ahkar-kyaw/e_me599_Hermes/01_document/Hermes_LaTeX_Thesis/chapters/chapter02.tex

\chapter{Background and Literature Review} \label{sec:Background and Literature Review}
    [aaa]

\section{Inverted-Pendulum Robots} \label{sec:Inverted-Pendulum Robots}
    [aaa]

\section{Mecanum Wheels} \label{sec:Mecanum Wheels}
    [aaa]

\section{CMD Theory} \label{sec:CMD Theory}
    [aaa]

\section{Relevent Control Methods} \label{sec:Relevent Control Methods}
    [aaa]

\section{Practical Nonidealities} \label{sec:Practical Nonidealities}
    [aaa]
