ahkar-kyaw/e_me599_Hermes/01_document/Hermes_LaTeX_Thesis/chapters/chapter04.tex

\chapter{Mechanical Design} \label{sec:Mechanical Design}
    [aaa]

\section{Geometry} \label{sec:Geometry}
    [aaa]

\section{Structure} \label{sec:Structure}
    [aaa]

\section{Mass Properties} \label{sec:Mass Properties}
    [aaa]

\section{Wheels} \label{sec:Wheels}
    [aaa]

\section{Actuators} \label{sec:Actuators}
    [aaa]

\section{Manufacturability} \label{sec:Manufacturability}
    [aaa]

\section{Assembly} \label{sec:Assembly}
    [aaa]

\section{Parameter Measurements} \label{sec:Parameter Measurements}
    [aaa]
