ahkar-kyaw/e_me599_Hermes/01_document/Hermes_LaTeX_Thesis/chapters/chapter05.tex

\chapter{Electrical and Embedded Design} \label{sec:Electrical and Embedded Design}
    [aaa]

\section{Power System} \label{sec:Power System}
    [aaa]

\section{Communication} \label{sec:Communication}
    [aaa]

\section{Sensing} \label{sec:Sensing}
    [aaa]

\section{Custom Electronics} \label{sec:Custom Electronics}
    [aaa]

\section{Timing} \label{sec:Timing}
    [aaa]

\section{Firmware Architecture} \label{sec:Firmware Architecture}
    [aaa]

\section{Safety States} \label{sec:Safety States}
    [aaa]
