ahkar-kyaw/e_me599_Hermes/01_document/Hermes_LaTeX_Thesis/chapters/chapter06.tex

\chapter{Modeling and System Identification} \label{sec:Modeling and System Identification}
    [aaa]

\section{Coordinates} \label{sec:Coordinates}
    [aaa]

\section{Assumptions} \label{sec:Assumptions}
    [aaa]

\section{Kinematics} \label{sec:Kinematics}
    [aaa]

\section{Reduced Dynamics} \label{sec:Reduced Dynamics}
    [aaa]

\section{Linearization} \label{sec:Linearization}
    [aaa]

\section{Actuator Model} \label{sec:Actuator Model}
    [aaa]

\section{Measured Parameters} \label{sec:Measured Parameters}
    [aaa]

\section{Validation Plan} \label{sec:Validation Plan}
    [aaa]
