ahkar-kyaw/e_me599_Hermes/01_document/Hermes_LaTeX_Thesis/chapters/chapter07.tex

\chapter{State Estimation and Control} \label{sec:State Estimation and Control}
    [aaa]

\section{Estimator} \label{sec:Estimator}
    [aaa]

\section{Balance Controller} \label{sec:Balance Controller}
    [aaa]

\section{Outer Loops} \label{sec:Outer Loops}
    [aaa]

\section{Command Allocation} \label{sec:Command Allocation}
    [aaa]

\section{Filters} \label{sec:Filters}
    [aaa]

\section{Saturation} \label{sec:Saturation}
    [aaa]

\section{Stability} \label{sec:Stability}
    [aaa]
    
\section{Controllability Discussion} \label{sec:Controllability Discussion}
    [aaa]
