ahkar-kyaw/e_me599_Hermes/01_document/Hermes_LaTeX_Thesis/chapters/chapter08.tex

\chapter{Simulation} \label{sec:Simulation}
    [aaa]

\section{/* Test case matched to planned hardware experiments */} \label{sec:/* Test case matched to planned hardware experiments */}
    [aaa]

\section{Sensitivity Studies} \label{sec:Sensitivity Studies}
    [aaa]

\section{Expected Limits} \label{sec:Expected Limits}
    [aaa]
