ahkar-kyaw/e_me599_Hermes/01_document/Hermes_LaTeX_Thesis/chapters/chapter09.tex

\chapter{Experimental Methods} \label{sec:Experimental Methods}
    [aaa]

\section{Apparatus} \label{sec:Apparatus}
    [aaa]

\section{Calibration} \label{sec:Calibration}
    [aaa]

\section{Test Matrix} \label{sec:Test Matrix}
    [aaa]

\section{Repetitions} \label{sec:Repetitions}
    [aaa]

\section{Metrics} \label{sec:Metrics}
    [aaa]

\section{Uncertainty} \label{sec:Uncertainty}
    [aaa]

\section{Data Processing} \label{sec:Data Processing}
    [aaa]
