ahkar-kyaw/e_me599_Hermes/01_document/Hermes_LaTeX_Thesis/frontmatter/abstract.tex

[aaa]. This thesis documents the design and development of Hermes, a self-balancing mobile robot with a collinear four-wheel mecanum drive. The project integrates [aaa]. [aaa]
