ahkar-kyaw/e_me599_Hermes/01_document/Hermes_LaTeX_Thesis/frontmatter/information.tex

\title{Design and Development of a Self-Balancing Mobile Robot with a Collinear Four-Wheel Mecanum Drive}
\author{Ahkar Kyaw}
\degreemonth{December}
\degreeyear{2026}
\degree{Master of Science}
\field{Mechanical Engineering}
\numberofmembers{3}
   \chair{Hasan Mohammad, Ph.D. \linebreak Assistant Professor of Mechanical Engineering}
   \othermemberA{Charlie T. Refvem, Ph.D. \linebreak Lecturer of Mechanical Engineering}
   \othermemberB{Carlos Diaz Alvarenga, Ph.D. \linebreak Professor of Computer Engineering}
   \othermemberC{Faculty Member, Ph.D. \linebreak Professor of Some Department}
   \othermemberD{Faculty Member, Ph.D. \linebreak Professor of Some Department}
   \othermemberE{Faculty Member, Ph.D. \linebreak Professor of Some Department}
   \othermemberF{Faculty Member, Ph.D. \linebreak Professor of Some Department}
   \othermemberG{Faculty Member, Ph.D. \linebreak Professor of Some Department}
   \othermemberH{Faculty Member, Ph.D. \linebreak Professor of Some Department}
   \othermemberI{Faculty Member, Ph.D. \linebreak Professor of Some Department}
\keywords{Mecanum wheel, self-balancing robot, omnidirectional mobility, wheeled inverted pendulum, embedded control, CAN bus, mechatronics}
