ahkar-kyaw/e_me599_Hermes/01_document/Hermes_LaTeX_Thesis/config/metadata.tex

\newcommand{\ThesisTitle}{Design and Development of Hermes: A Self-Balancing Mobile Robot with a Collinear Four-Wheel Mecanum Drive}
\newcommand{\ThesisAuthor}{Ahkar Kyaw}
\newcommand{\UniversityName}{California Polytechnic State University, San Luis Obispo}
\newcommand{\DegreeName}{Master of Science in Mechanical Engineering}
\newcommand{\SubmissionDate}{December 2026}
\newcommand{\CopyrightYear}{2026}

\newcommand{\CommitteeChairName}{Hasan Mohammad, Ph.D.}
\newcommand{\CommitteeChairTitle}{COMMITTEE CHAIR TITLE}
\newcommand{\CommitteeMemberOneName}{Charlie T. Refvem}
\newcommand{\CommitteeMemberOneTitle}{COMMITTEE MEMBER TITLE}
\newcommand{\CommitteeMemberTwoName}{Carlos Diaz Alvarenga, Ph.D.}
\newcommand{\CommitteeMemberTwoTitle}{COMMITTEE MEMBER TITLE}

% Change this to \usebibliographytrue after adding cited entries to references.bib.
\newif\ifusebibliography
\usebibliographyfalse
