ahkar-kyaw/e_me599_Hermes/01_document/Hermes_LaTeX_Thesis/main.pdf

DESIGN AND DEVELOPMENT OF A SELF-BALANCING MOBILE ROBOT

WITH A COLLINEAR FOUR-WHEEL MECANUM DRIVE

A Thesis

presented to

the Faculty of California Polytechnic State University,

San Luis Obispo

In Partial Fulfillment

of the Requirements for the Degree

Master of Science in Mechanical Engineering

by

Ahkar Kyaw

December 2026

© 2026

Ahkar Kyaw

ALL RIGHTS RESERVED

ii

COMMITTEE MEMBERSHIP

TITLE: Design and Development of a Self-Balancing Mobile

Robot with a Collinear Four-Wheel Mecanum Drive

AUTHOR: Ahkar Kyaw

DATE SUBMITTED: December 2026

COMMITTEE CHAIR: Hasan Mohammad, Ph.D. Assistant Professor of Mechanical Engineering

COMMITTEE MEMBER: Charlie T. Refvem, Ph.D. Lecturer of Mechanical Engineering

COMMITTEE MEMBER: Carlos Diaz Alvarenga, Ph.D. Professor of Computer Engineering

iii

ABSTRACT

Design and Development of a Self-Balancing Mobile Robot with a Collinear

Four-Wheel Mecanum Drive

Ahkar Kyaw

[aaa]. This thesis documents the design and development of Hermes, a self-balancing

mobile robot with a collinear four-wheel mecanum drive. The project integrates [aaa].

[aaa]

Keywords: Mecanum wheel, self-balancing robot, omnidirectional mobility, wheeled

inverted pendulum, embedded control, CAN bus, mechatronics

iv

TABLE OF CONTENTS

Page

CHAPTER

v

vi

vii

APPENDICES

viii

ix

LIST OF TABLES

Table | Page

x

LIST OF FIGURES

Figure | Page
B.2 | This is the caption for another image where the description is rather
C.2 | This is the caption for another image where the description is rather

xi

LIST OF SYMBOLS

Number Sets

C | Complex numbers
H | Quaternions
R | Real numbers

Other Symbols

µ | Friction index
T | Lorem ipsum dolor sit amet, consectetuer adipiscing elit. Ut purus elit, ve- stibulum ut, placerat ac, adipiscing vitae, felis. Curabitur dictum gravida mauris. Nam arcu libero, nonummy eget, consectetuer id, vulputate a, ma- gna. Donec vehicula augue eu neque. Pellentesque habitant morbi tristique senectus et netus et malesuada fames ac turpis egestas. Mauris ut leo. Cras viverra metus rhoncus sem. Nulla et lectus vestibulum urna fringilla ultrices. Phasellus eu tellus sit amet tortor gravida placerat. Integer sapien est, iaculis in, pretium quis, viverra ac, nunc. Praesent eget sem vel leo ultrices biben- dum. Aenean faucibus. Morbi dolor nulla, malesuada eu, pulvinar at, mollis ac, nulla. Curabitur auctor semper nulla. Donec varius orci eget risus. Duis nibh mi, congue eu, accumsan eleifend, sagittis quis, diam. Duis eget orci sit amet orci dignissim rutrum. Nam dui ligula, fringilla a, euismod sodales, sollicitudin vel, wisi. Morbi auctor lorem non justo. Nam lacus libero, pretium at, lobortis vitae, ultricies et, tellus. Donec aliquet, tortor sed accumsan bibendum, erat ligula aliquet magna, vitae ornare odio metus a mi. Morbi ac orci et nisl hendrerit mollis. Suspendisse ut massa. Cras nec ante. Pellentesque a nulla. Cum sociis natoque penatibus et magnis dis parturient montes, nascetur ridiculus mus. Aliquam tincidunt urna. Nulla ullamcorper vestibulum turpis. Pellentesque cursus luctus mauris. Nulla malesuada porttitor diam. Donec felis erat, congue non, volutpat at, tincidunt tristique, libero. Vivamus viverra fermentum felis. Donec nonummy pellentesque ante. Phasellus adipiscing semper elit. Proin fermentum massa ac quam. Sed diam turpis, molestie vitae, placerat a, molestie nec, leo. Maecenas lacinia. Nam ipsum ligula, eleifend at, accumsan nec, suscipit a, ipsum. Morbi blandit ligula feugiat magna. Nunc eleifend consequat lorem. Sed lacinia nulla vitae enim. Pellentesque tincidunt purus vel magna. Integer non enim. Prae- sent euismod nunc eu purus. Donec bibendum quam in tellus. Nullam cursus pulvinar lectus. Donec et mi. Nam vulputate metus eu enim. Vestibulum pellentesque felis eu massa.
| xii

V Constant volume

Physics Constants

c | Speed of light in a vacuum
G | Gravitational constant
h | Planck constant

xiii

Chapter 1

INTRODUCTION

[aaa]

### 1.1 Motivation

[aaa]

### 1.2 Problem Statement

[aaa]

### 1.3 Research Gap

[aaa]

### 1.4 Questions

[aaa]

### 1.5 Contributions

[aaa]

### 1.6 Scope

[aaa]

Chapter 2

BACKGROUND AND LITERATURE REVIEW

[aaa]

### 2.1 Inverted-Pendulum Robots

[aaa]

### 2.2 Mecanum Wheels

[aaa]

### 2.3 CMD Theory

[aaa]

### 2.4 Relevent Control Methods

[aaa]

### 2.5 Practical Nonidealities

[aaa]

Chapter 3

SYSTEM REQUIREMENTS AND ARCHITECTURE

[aaa]

### 3.1 Requirements

[aaa]

### 3.2 System Decomposition

[aaa]

### 3.3 Safety

[aaa]

### 3.4 Major Design Decision

[aaa]

Chapter 4

MECHANICAL DESIGN

[aaa]

### 4.1 Geometry

[aaa]

### 4.2 Structure

[aaa]

### 4.3 Mass Properties

[aaa]

### 4.4 Wheels

[aaa]

### 4.5 Actuators

[aaa]

### 4.6 Manufacturability

[aaa]

### 4.7 Assembly

[aaa]

### 4.8 Parameter Measurements

[aaa]

Chapter 5

ELECTRICAL AND EMBEDDED DESIGN

[aaa]

### 5.1 Power System

[aaa]

### 5.2 Communication

[aaa]

### 5.3 Sensing

[aaa]

### 5.4 Custom Electronics

[aaa]

### 5.5 Timing

[aaa]

### 5.6 Firmware Architecture

[aaa]

### 5.7 Safety States

[aaa]

Chapter 6

MODELING AND SYSTEM IDENTIFICATION

[aaa]

### 6.1 Coordinates

[aaa]

### 6.2 Assumptions

[aaa]

### 6.3 Kinematics

[aaa]

### 6.4 Reduced Dynamics

[aaa]

### 6.5 Linearization

[aaa]

### 6.6 Actuator Model

[aaa]

### 6.7 Measured Parameters

[aaa]

### 6.8 Validation Plan

[aaa]

Chapter 7

MODELING AND SYSTEM IDENTIFICATION

[aaa]

### 7.1 Coordinates

[aaa]

### 7.2 Assumptions

[aaa]

### 7.3 Kinematics

[aaa]

### 7.4 Reduced Dynamics

[aaa]

### 7.5 Linearization

[aaa]

### 7.6 Actuator Model

[aaa]

### 7.7 Measured Parameters

[aaa]

### 7.8 Validation Plan

[aaa]

Chapter 8

STATE ESTIMATION AND CONTROL

[aaa]

### 8.1 Estimator

[aaa]

### 8.2 Balance Controller

[aaa]

### 8.3 Outer Loops

[aaa]

### 8.4 Command Allocation

[aaa]

### 8.5 Filters

[aaa]

### 8.6 Saturation

[aaa]

### 8.7 Stability

[aaa]

### 8.8 Controllability Discussion

[aaa]

Chapter 9

SIMULATION

[aaa]

9.1 /* Test case matched to planned hardware experiments */

[aaa]

### 9.2 Sensitivity Studies

[aaa]

### 9.3 Expected Limits

[aaa]

Chapter 10

EXPERIMENTAL METHODS

[aaa]

### 10.1 Apparatus

[aaa]

### 10.2 Calibration

[aaa]

### 10.3 Test Matrix

[aaa]

### 10.4 Repetitions

[aaa]

### 10.5 Metrics

[aaa]

### 10.6 Uncertainty

[aaa]

### 10.7 Data Processing

[aaa]

Chapter 11

RESULTS AND DISCUSSION

[aaa]

### 11.1 Model-to-hardware comparison

[aaa]

### 11.2 Motion Tests

[aaa]

### 11.3 Disturbance Tests

[aaa]

### 11.4 Payload Robustness

[aaa]

### 11.5 Limitations

[aaa]

Chapter 12

CONCLUSIONS AND FUTURE WORK

[aaa]

12.1 /* Answers to the research questions */

[aaa]

12.2 /* Demonstrated contribution */

[aaa]

### 12.3 Next Steps

[aaa]

BIBLIOGRAPHY

[1] P. A. M. Dirac. The principles of quantum mechanics. International Series of

Monographs on Physics. Clarendon Press, 1981. isbn: 9780198520115.

[2] M. Drela and M. B. Giles. “Viscous-inviscid analysis of transonic and low

Reynolds number airfoils”. In: 4

th Applied Aerodynamics Conference. AIAA

1986-1786. San Diego, CA: American Institute of Aeronautics and Astronau-

tics, June 1986. doi: 10.2514/6.1986-1786. (https://doi.org/10.2514/6.1986-1786)

[3] H. L. Dryden. “Aerodynamics of cooling”. In: Aerodynamic theory: a general

review of progress. Ed. by W. F. Durand. Vol. 6. Springer, 1943. Chap. T.

[4] A. Einstein. “Zur Elektrodynamik bewegter K¨orper”. German. In: Annalen der

Physik 322.10 (1905). Translation: “On the Electrodynamics of Moving Bodies”,

pp. 891–921. doi: 10.1002/andp.19053221004. (https://doi.org/10.1002/andp.19053221004)

[5] A. Guenther, D. D. Marshall, C. Ford, et al. Cal Poly thesis template. 2024. url:

https://github.com/CalPolyCSC/thesis-template (visited on 08/16/2024).

[6] M. R. Head. Entrainment in the turbulent boundary layer. ARC Reports and

Memoranda 3152. Ministry of Aviation, Aeronautical Research Council, Sept.

1958.

[7] S. Kottwitz. Example: a Venn diagram with PDF blending. 2015. url: https:

//texample.net/tikz/examples/venn/ (visited on 08/16/2024).

[8] P. Kotz. “This paper has a really, really, really, really, really, really, really, really,

really, really, really, really, really, really, really, really, really, really, really, really,

really, really, really, really, really, really, really, really, really, really, really, really,

really, really, really, really, really, really, really, really, really, really, really, really,

really, really, really, really, really, really, really, really long name”. In: Long

Names 2000 (2025), pp. 111–128.

[9] P. Koutsovasilis and M. Beitelschmidt. “Comparison of model reduction tech-

niques for large mechanical systems”. In: Multibody System Dynamics 20.2

(2008), pp. 111–128. issn: 1384-5640. doi: 10.1007/s11044-008-9116-4. (https://doi.org/10.1007/s11044-008-9116-4)

[10] G. A. Lopez, M. Taufer, and P. J. Teller. “Evaluation of IEEE 754 floating-

point arithmetic compliance across a wide range of heterogeneous computers”.

In: Proceedings of the 2007 Conference on Diversity in Computing – TAPIA ’07.

ACM Press, 2007, p. 1. isbn: 978-1-59593-866-4. doi: 10.1145/1347787.1347793. (https://doi.org/10.1145/1347787.1347793)

[11] K. Wieghardt and W. Tillmann. On the turbulent friction layer for rising pres-

sure. NACA Technical Memorandum 1314. National Advisory Committee for

Aeronautics, Oct. 1951.

Appendix A

ACRONYMS

CFD | Computational Fluid Dynamics
ODE | Ordinary Differential Equations
BFF | Best Friends Forever

NASA National Aeronautics and Space Administration

Appendix B

FIRST APPENDIX

Lorem ipsum dolor sit amet, consectetuer adipiscing elit. Ut purus elit, vestibulum

ut, placerat ac, adipiscing vitae, felis. Curabitur dictum gravida mauris. Nam arcu

libero, nonummy eget, consectetuer id, vulputate a, magna. Donec vehicula augue eu

neque. Pellentesque habitant morbi tristique senectus et netus et malesuada fames

ac turpis egestas. Mauris ut leo. Cras viverra metus rhoncus sem. Nulla et lectus

vestibulum urna fringilla ultrices. Phasellus eu tellus sit amet tortor gravida placerat.

Integer sapien est, iaculis in, pretium quis, viverra ac, nunc. Praesent eget sem vel leo

ultrices bibendum. Aenean faucibus. Morbi dolor nulla, malesuada eu, pulvinar at,

mollis ac, nulla. Curabitur auctor semper nulla. Donec varius orci eget risus. Duis

nibh mi, congue eu, accumsan eleifend, sagittis quis, diam. Duis eget orci sit amet orci

dignissim rutrum. Nam dui ligula, fringilla a, euismod sodales, sollicitudin vel, wisi.

Morbi auctor lorem non justo. Nam lacus libero, pretium at, lobortis vitae, ultricies

et, tellus. Donec aliquet, tortor sed accumsan bibendum, erat ligula aliquet magna,

vitae ornare odio metus a mi. Morbi ac orci et nisl hendrerit mollis. Suspendisse

ut massa. Cras nec ante. Pellentesque a nulla. Cum sociis natoque penatibus et

magnis dis parturient montes, nascetur ridiculus mus. Aliquam tincidunt urna. Nulla

ullamcorper vestibulum turpis. Pellentesque cursus luctus mauris.

Table B.1: This is the caption for the first table.

Col1 Col2 Col3 Col4 Col1 Col2 Col3 Col4
1 | 676 8837 | 787 | 544 | 22 | 908 | 229
2 | 732 | 78 5415 | 887 | 343 1112 | 870
3 | 545 | 778 7507 5554 5432 9867 | 9
4 | 545 1874 7560 | 102 | 562 | 223 | 792
5 | 88 | 788 6344 | 45 | 998 | 776 | 2

Table B.2: This is the caption for another table.

Col1 Col2 Col3 Col4 Col1 Col2 Col3 Col4
1 | 676 8837 | 787 | 544 | 22 | 908 | 229
2 | 732 | 78 5415 | 887 | 343 1112 | 870
3 | 545 | 778 7507 5554 5432 9867 | 9
4 | 545 1874 7560 | 102 | 562 | 223 | 792
5 | 88 | 788 6344 | 45 | 998 | 776 | 2
B.1 | A Section

Nulla malesuada porttitor diam. Donec felis erat, congue non, volutpat at, tincidunt

tristique, libero. Vivamus viverra fermentum felis. Donec nonummy pellentesque

ante. Phasellus adipiscing semper elit. Proin fermentum massa ac quam. Sed diam

turpis, molestie vitae, placerat a, molestie nec, leo. Maecenas lacinia. Nam ipsum li-

gula, eleifend at, accumsan nec, suscipit a, ipsum. Morbi blandit ligula feugiat magna.

Nunc eleifend consequat lorem. Sed lacinia nulla vitae enim. Pellentesque tincidunt

purus vel magna. Integer non enim. Praesent euismod nunc eu purus. Donec biben-

dum quam in tellus. Nullam cursus pulvinar lectus. Donec et mi. Nam vulputate

metus eu enim. Vestibulum pellentesque felis eu massa. Quisque ullamcorper place-

rat ipsum. Cras nibh. Morbi vel justo vitae lacus tincidunt ultrices. Lorem ipsum

dolor sit amet, consectetuer adipiscing elit. In hac habitasse platea dictumst. Integer

tempus convallis augue. Etiam facilisis. Nunc elementum fermentum wisi. Aenean

placerat. Ut imperdiet, enim sed gravida sollicitudin, felis odio placerat quam, ac

pulvinar elit purus eget enim. Nunc vitae tortor. Proin tempus nibh sit amet nisl.

Vivamus quis tortor vitae risus porta vehicula.

Fusce mauris. Vestibulum luctus nibh at lectus. Sed bibendum, nulla a faucibus

semper, leo velit ultricies tellus, ac venenatis arcu wisi vel nisl. Vestibulum diam.

Aliquam pellentesque, augue quis sagittis posuere, turpis lacus congue quam, in hen-

drerit risus eros eget felis. Maecenas eget erat in sapien mattis porttitor. Vestibulum

# Image

Figure B.1: This is the caption for first image.

porttitor. Nulla facilisi. Sed a turpis eu lacus commodo facilisis. Morbi fringilla,

wisi in dignissim interdum, justo lectus sagittis dui, et vehicula libero dui cursus dui.

Mauris tempor ligula sed lacus. Duis cursus enim ut augue. Cras ac magna. Cras

nulla. Nulla egestas. Curabitur a leo. Quisque egestas wisi eget nunc. Nam feugiat

lacus vel est. Curabitur consectetuer.

B.1.1 A Subsection

Suspendisse vel felis. Ut lorem lorem, interdum eu, tincidunt sit amet, laoreet vitae,

arcu. Aenean faucibus pede eu ante. Praesent enim elit, rutrum at, molestie non,

nonummy vel, nisl. Ut lectus eros, malesuada sit amet, fermentum eu, sodales cursus,

magna. Donec eu purus. Quisque vehicula, urna sed ultricies auctor, pede lorem

egestas dui, et convallis elit erat sed nulla. Donec luctus. Curabitur et nunc. Aliquam

dolor odio, commodo pretium, ultricies non, pharetra in, velit. Integer arcu est,

nonummy in, fermentum faucibus, egestas vel, odio.

Sed commodo posuere pede. Mauris ut est. Ut quis purus. Sed ac odio. Sed vehicula

hendrerit sem. Duis non odio. Morbi ut dui. Sed accumsan risus eget odio. In

# Golden ratio

# (Original size: 32.361×200 bp)

Figure B.2: This is the caption for another image where the description is rather long and will probably go beyond one line.

hac habitasse platea dictumst. Pellentesque non elit. Fusce sed justo eu urna porta

tincidunt. Mauris felis odio, sollicitudin sed, volutpat a, ornare ac, erat. Morbi quis

dolor. Donec pellentesque, erat ac sagittis semper, nunc dui lobortis purus, quis

congue purus metus ultricies tellus. Proin et quam. Class aptent taciti sociosqu ad

litora torquent per conubia nostra, per inceptos hymenaeos. Praesent sapien turpis,

fermentum vel, eleifend faucibus, vehicula eu, lacus.

Pellentesque habitant morbi tristique senectus et netus et malesuada fames ac turpis

egestas. Donec odio elit, dictum in, hendrerit sit amet, egestas sed, leo. Praesent

feugiat sapien aliquet odio. Integer vitae justo. Aliquam vestibulum fringilla lorem.

Sed neque lectus, consectetuer at, consectetuer sed, eleifend ac, lectus. Nulla facilisi.

Pellentesque eget lectus. Proin eu metus. Sed porttitor. In hac habitasse platea

dictumst. Suspendisse eu lectus. Ut mi mi, lacinia sit amet, placerat et, mollis vitae,

dui. Sed ante tellus, tristique ut, iaculis eu, malesuada ac, dui. Mauris nibh leo,

facilisis non, adipiscing quis, ultrices a, dui.

Table B.3: This is the caption for yet another table.

Col1 Col2 Col3 Col4 Col1 Col2 Col3 Col4
1 | 676 8837 | 787 | 544 | 22 | 908 | 229
2 | 732 | 78 5415 | 887 | 343 1112 | 870
3 | 545 | 778 7507 5554 5432 9867 | 9
4 | 545 1874 7560 | 102 | 562 | 223 | 792
5 | 88 | 788 6344 | 45 | 998 | 776 | 2
B.2 | Another Section

Lorem ipsum dolor sit amet, consectetuer adipiscing elit. Ut purus elit, vestibulum

ut, placerat ac, adipiscing vitae, felis. Curabitur dictum gravida mauris. Nam arcu

libero, nonummy eget, consectetuer id, vulputate a, magna. Donec vehicula augue eu

neque. Pellentesque habitant morbi tristique senectus et netus et malesuada fames

ac turpis egestas. Mauris ut leo. Cras viverra metus rhoncus sem. Nulla et lectus

vestibulum urna fringilla ultrices. Phasellus eu tellus sit amet tortor gravida placerat.

Integer sapien est, iaculis in, pretium quis, viverra ac, nunc. Praesent eget sem vel leo

ultrices bibendum. Aenean faucibus. Morbi dolor nulla, malesuada eu, pulvinar at,

mollis ac, nulla. Curabitur auctor semper nulla. Donec varius orci eget risus. Duis

nibh mi, congue eu, accumsan eleifend, sagittis quis, diam. Duis eget orci sit amet

orci dignissim rutrum.

Nam dui ligula, fringilla a, euismod sodales, sollicitudin vel, wisi. Morbi auctor lorem

non justo. Nam lacus libero, pretium at, lobortis vitae, ultricies et, tellus. Donec

aliquet, tortor sed accumsan bibendum, erat ligula aliquet magna, vitae ornare odio

metus a mi. Morbi ac orci et nisl hendrerit mollis. Suspendisse ut massa. Cras

nec ante. Pellentesque a nulla. Cum sociis natoque penatibus et magnis dis partu-

rient montes, nascetur ridiculus mus. Aliquam tincidunt urna. Nulla ullamcorper

vestibulum turpis. Pellentesque cursus luctus mauris.

B.2.1 Another Subsection

Nulla malesuada porttitor diam. Donec felis erat, congue non, volutpat at, tincidunt

tristique, libero. Vivamus viverra fermentum felis. Donec nonummy pellentesque

ante. Phasellus adipiscing semper elit. Proin fermentum massa ac quam. Sed diam

turpis, molestie vitae, placerat a, molestie nec, leo. Maecenas lacinia. Nam ipsum

ligula, eleifend at, accumsan nec, suscipit a, ipsum. Morbi blandit ligula feugiat

magna. Nunc eleifend consequat lorem. Sed lacinia nulla vitae enim. Pellentesque

tincidunt purus vel magna. Integer non enim. Praesent euismod nunc eu purus.

Donec bibendum quam in tellus. Nullam cursus pulvinar lectus. Donec et mi. Nam

vulputate metus eu enim. Vestibulum pellentesque felis eu massa.

Quisque ullamcorper placerat ipsum. Cras nibh. Morbi vel justo vitae lacus tincidunt

ultrices. Lorem ipsum dolor sit amet, consectetuer adipiscing elit. In hac habitasse

platea dictumst. Integer tempus convallis augue. Etiam facilisis. Nunc elementum

fermentum wisi. Aenean placerat. Ut imperdiet, enim sed gravida sollicitudin, felis

odio placerat quam, ac pulvinar elit purus eget enim. Nunc vitae tortor. Proin

tempus nibh sit amet nisl. Vivamus quis tortor vitae risus porta vehicula.

Fusce mauris. Vestibulum luctus nibh at lectus. Sed bibendum, nulla a faucibus

semper, leo velit ultricies tellus, ac venenatis arcu wisi vel nisl. Vestibulum diam.

Aliquam pellentesque, augue quis sagittis posuere, turpis lacus congue quam, in hen-

drerit risus eros eget felis. Maecenas eget erat in sapien mattis porttitor. Vestibulum

porttitor. Nulla facilisi. Sed a turpis eu lacus commodo facilisis. Morbi fringilla,

wisi in dignissim interdum, justo lectus sagittis dui, et vehicula libero dui cursus dui.

Mauris tempor ligula sed lacus. Duis cursus enim ut augue. Cras ac magna. Cras

nulla. Nulla egestas. Curabitur a leo. Quisque egestas wisi eget nunc. Nam feugiat

lacus vel est. Curabitur consectetuer.

B.2.1.1 A Sub-Subsection

Suspendisse vel felis. Ut lorem lorem, interdum eu, tincidunt sit amet, laoreet vitae,

arcu. Aenean faucibus pede eu ante. Praesent enim elit, rutrum at, molestie non,

nonummy vel, nisl. Ut lectus eros, malesuada sit amet, fermentum eu, sodales cursus,

magna. Donec eu purus. Quisque vehicula, urna sed ultricies auctor, pede lorem

egestas dui, et convallis elit erat sed nulla. Donec luctus. Curabitur et nunc. Aliquam

dolor odio, commodo pretium, ultricies non, pharetra in, velit. Integer arcu est,

nonummy in, fermentum faucibus, egestas vel, odio.

Sed commodo posuere pede. Mauris ut est. Ut quis purus. Sed ac odio. Sed vehicula

hendrerit sem. Duis non odio. Morbi ut dui. Sed accumsan risus eget odio. In

hac habitasse platea dictumst. Pellentesque non elit. Fusce sed justo eu urna porta

tincidunt. Mauris felis odio, sollicitudin sed, volutpat a, ornare ac, erat. Morbi quis

dolor. Donec pellentesque, erat ac sagittis semper, nunc dui lobortis purus, quis

congue purus metus ultricies tellus. Proin et quam. Class aptent taciti sociosqu ad

litora torquent per conubia nostra, per inceptos hymenaeos. Praesent sapien turpis,

fermentum vel, eleifend faucibus, vehicula eu, lacus.

Pellentesque habitant morbi tristique senectus et netus et malesuada fames ac turpis

egestas. Donec odio elit, dictum in, hendrerit sit amet, egestas sed, leo. Praesent

feugiat sapien aliquet odio. Integer vitae justo. Aliquam vestibulum fringilla lorem.

Sed neque lectus, consectetuer at, consectetuer sed, eleifend ac, lectus. Nulla facilisi.

Pellentesque eget lectus. Proin eu metus. Sed porttitor. In hac habitasse platea

dictumst. Suspendisse eu lectus. Ut mi mi, lacinia sit amet, placerat et, mollis vitae,

dui. Sed ante tellus, tristique ut, iaculis eu, malesuada ac, dui. Mauris nibh leo,

facilisis non, adipiscing quis, ultrices a, dui.

Appendix C

SECOND APPENDIX

Lorem ipsum dolor sit amet, consectetuer adipiscing elit. Ut purus elit, vestibulum

ut, placerat ac, adipiscing vitae, felis. Curabitur dictum gravida mauris. Nam arcu

libero, nonummy eget, consectetuer id, vulputate a, magna. Donec vehicula augue eu

neque. Pellentesque habitant morbi tristique senectus et netus et malesuada fames

ac turpis egestas. Mauris ut leo. Cras viverra metus rhoncus sem. Nulla et lectus

vestibulum urna fringilla ultrices. Phasellus eu tellus sit amet tortor gravida placerat.

Integer sapien est, iaculis in, pretium quis, viverra ac, nunc. Praesent eget sem vel leo

ultrices bibendum. Aenean faucibus. Morbi dolor nulla, malesuada eu, pulvinar at,

mollis ac, nulla. Curabitur auctor semper nulla. Donec varius orci eget risus. Duis

nibh mi, congue eu, accumsan eleifend, sagittis quis, diam. Duis eget orci sit amet orci

dignissim rutrum. Nam dui ligula, fringilla a, euismod sodales, sollicitudin vel, wisi.

Morbi auctor lorem non justo. Nam lacus libero, pretium at, lobortis vitae, ultricies

et, tellus. Donec aliquet, tortor sed accumsan bibendum, erat ligula aliquet magna,

vitae ornare odio metus a mi. Morbi ac orci et nisl hendrerit mollis. Suspendisse

ut massa. Cras nec ante. Pellentesque a nulla. Cum sociis natoque penatibus et

magnis dis parturient montes, nascetur ridiculus mus. Aliquam tincidunt urna. Nulla

ullamcorper vestibulum turpis. Pellentesque cursus luctus mauris.

Table C.1: This is the caption for the first table.

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

Table C.2: This is the caption for another table.

Col1 Col2 Col3 Col4 Col1 Col2 Col3 Col4
1 | 676 8837 | 787 | 544 | 22 | 908 | 229
2 | 732 | 78 5415 | 887 | 343 1112 | 870
3 | 545 | 778 7507 5554 5432 9867 | 9
4 | 545 1874 7560 | 102 | 562 | 223 | 792
5 | 88 | 788 6344 | 45 | 998 | 776 | 2
C.1 | A Section

Nulla malesuada porttitor diam. Donec felis erat, congue non, volutpat at, tincidunt

tristique, libero. Vivamus viverra fermentum felis. Donec nonummy pellentesque

ante. Phasellus adipiscing semper elit. Proin fermentum massa ac quam. Sed diam

turpis, molestie vitae, placerat a, molestie nec, leo. Maecenas lacinia. Nam ipsum li-

gula, eleifend at, accumsan nec, suscipit a, ipsum. Morbi blandit ligula feugiat magna.

Nunc eleifend consequat lorem. Sed lacinia nulla vitae enim. Pellentesque tincidunt

purus vel magna. Integer non enim. Praesent euismod nunc eu purus. Donec biben-

dum quam in tellus. Nullam cursus pulvinar lectus. Donec et mi. Nam vulputate

metus eu enim. Vestibulum pellentesque felis eu massa. Quisque ullamcorper place-

rat ipsum. Cras nibh. Morbi vel justo vitae lacus tincidunt ultrices. Lorem ipsum

dolor sit amet, consectetuer adipiscing elit. In hac habitasse platea dictumst. Integer

tempus convallis augue. Etiam facilisis. Nunc elementum fermentum wisi. Aenean

placerat. Ut imperdiet, enim sed gravida sollicitudin, felis odio placerat quam, ac

pulvinar elit purus eget enim. Nunc vitae tortor. Proin tempus nibh sit amet nisl.

Vivamus quis tortor vitae risus porta vehicula.

Fusce mauris. Vestibulum luctus nibh at lectus. Sed bibendum, nulla a faucibus

semper, leo velit ultricies tellus, ac venenatis arcu wisi vel nisl. Vestibulum diam.

Aliquam pellentesque, augue quis sagittis posuere, turpis lacus congue quam, in hen-

drerit risus eros eget felis. Maecenas eget erat in sapien mattis porttitor. Vestibulum

# Image

Figure C.1: This is the caption for first image.

porttitor. Nulla facilisi. Sed a turpis eu lacus commodo facilisis. Morbi fringilla,

wisi in dignissim interdum, justo lectus sagittis dui, et vehicula libero dui cursus dui.

Mauris tempor ligula sed lacus. Duis cursus enim ut augue. Cras ac magna. Cras

nulla. Nulla egestas. Curabitur a leo. Quisque egestas wisi eget nunc. Nam feugiat

lacus vel est. Curabitur consectetuer.

C.1.1 A Subsection

Suspendisse vel felis. Ut lorem lorem, interdum eu, tincidunt sit amet, laoreet vitae,

arcu. Aenean faucibus pede eu ante. Praesent enim elit, rutrum at, molestie non,

nonummy vel, nisl. Ut lectus eros, malesuada sit amet, fermentum eu, sodales cursus,

magna. Donec eu purus. Quisque vehicula, urna sed ultricies auctor, pede lorem

egestas dui, et convallis elit erat sed nulla. Donec luctus. Curabitur et nunc. Aliquam

dolor odio, commodo pretium, ultricies non, pharetra in, velit. Integer arcu est,

nonummy in, fermentum faucibus, egestas vel, odio.

Sed commodo posuere pede. Mauris ut est. Ut quis purus. Sed ac odio. Sed vehicula

hendrerit sem. Duis non odio. Morbi ut dui. Sed accumsan risus eget odio. In

# Golden ratio

# (Original size: 32.361×200 bp)

Figure C.2: This is the caption for another image where the description is rather long and will probably go beyond one line.

hac habitasse platea dictumst. Pellentesque non elit. Fusce sed justo eu urna porta

tincidunt. Mauris felis odio, sollicitudin sed, volutpat a, ornare ac, erat. Morbi quis

dolor. Donec pellentesque, erat ac sagittis semper, nunc dui lobortis purus, quis

congue purus metus ultricies tellus. Proin et quam. Class aptent taciti sociosqu ad

litora torquent per conubia nostra, per inceptos hymenaeos. Praesent sapien turpis,

fermentum vel, eleifend faucibus, vehicula eu, lacus.

Pellentesque habitant morbi tristique senectus et netus et malesuada fames ac turpis

egestas. Donec odio elit, dictum in, hendrerit sit amet, egestas sed, leo. Praesent

feugiat sapien aliquet odio. Integer vitae justo. Aliquam vestibulum fringilla lorem.

Sed neque lectus, consectetuer at, consectetuer sed, eleifend ac, lectus. Nulla facilisi.

Pellentesque eget lectus. Proin eu metus. Sed porttitor. In hac habitasse platea

dictumst. Suspendisse eu lectus. Ut mi mi, lacinia sit amet, placerat et, mollis vitae,

dui. Sed ante tellus, tristique ut, iaculis eu, malesuada ac, dui. Mauris nibh leo,

facilisis non, adipiscing quis, ultrices a, dui.

Table C.3: This is the caption for yet another table.

Col1 Col2 Col3 Col4 Col1 Col2 Col3 Col4
1 | 676 8837 | 787 | 544 | 22 | 908 | 229
2 | 732 | 78 5415 | 887 | 343 1112 | 870
3 | 545 | 778 7507 5554 5432 9867 | 9
4 | 545 1874 7560 | 102 | 562 | 223 | 792
5 | 88 | 788 6344 | 45 | 998 | 776 | 2
C.2 | Another Section

Lorem ipsum dolor sit amet, consectetuer adipiscing elit. Ut purus elit, vestibulum

ut, placerat ac, adipiscing vitae, felis. Curabitur dictum gravida mauris. Nam arcu

libero, nonummy eget, consectetuer id, vulputate a, magna. Donec vehicula augue eu

neque. Pellentesque habitant morbi tristique senectus et netus et malesuada fames

ac turpis egestas. Mauris ut leo. Cras viverra metus rhoncus sem. Nulla et lectus

vestibulum urna fringilla ultrices. Phasellus eu tellus sit amet tortor gravida placerat.

Integer sapien est, iaculis in, pretium quis, viverra ac, nunc. Praesent eget sem vel leo

ultrices bibendum. Aenean faucibus. Morbi dolor nulla, malesuada eu, pulvinar at,

mollis ac, nulla. Curabitur auctor semper nulla. Donec varius orci eget risus. Duis

nibh mi, congue eu, accumsan eleifend, sagittis quis, diam. Duis eget orci sit amet

orci dignissim rutrum.

Nam dui ligula, fringilla a, euismod sodales, sollicitudin vel, wisi. Morbi auctor lorem

non justo. Nam lacus libero, pretium at, lobortis vitae, ultricies et, tellus. Donec

aliquet, tortor sed accumsan bibendum, erat ligula aliquet magna, vitae ornare odio

metus a mi. Morbi ac orci et nisl hendrerit mollis. Suspendisse ut massa. Cras

nec ante. Pellentesque a nulla. Cum sociis natoque penatibus et magnis dis partu-

rient montes, nascetur ridiculus mus. Aliquam tincidunt urna. Nulla ullamcorper

vestibulum turpis. Pellentesque cursus luctus mauris.

C.2.1 Another Subsection

Nulla malesuada porttitor diam. Donec felis erat, congue non, volutpat at, tincidunt

tristique, libero. Vivamus viverra fermentum felis. Donec nonummy pellentesque

ante. Phasellus adipiscing semper elit. Proin fermentum massa ac quam. Sed diam

turpis, molestie vitae, placerat a, molestie nec, leo. Maecenas lacinia. Nam ipsum

ligula, eleifend at, accumsan nec, suscipit a, ipsum. Morbi blandit ligula feugiat

magna. Nunc eleifend consequat lorem. Sed lacinia nulla vitae enim. Pellentesque

tincidunt purus vel magna. Integer non enim. Praesent euismod nunc eu purus.

Donec bibendum quam in tellus. Nullam cursus pulvinar lectus. Donec et mi. Nam

vulputate metus eu enim. Vestibulum pellentesque felis eu massa.

Quisque ullamcorper placerat ipsum. Cras nibh. Morbi vel justo vitae lacus tincidunt

ultrices. Lorem ipsum dolor sit amet, consectetuer adipiscing elit. In hac habitasse

platea dictumst. Integer tempus convallis augue. Etiam facilisis. Nunc elementum

fermentum wisi. Aenean placerat. Ut imperdiet, enim sed gravida sollicitudin, felis

odio placerat quam, ac pulvinar elit purus eget enim. Nunc vitae tortor. Proin

tempus nibh sit amet nisl. Vivamus quis tortor vitae risus porta vehicula.

Fusce mauris. Vestibulum luctus nibh at lectus. Sed bibendum, nulla a faucibus

semper, leo velit ultricies tellus, ac venenatis arcu wisi vel nisl. Vestibulum diam.

Aliquam pellentesque, augue quis sagittis posuere, turpis lacus congue quam, in hen-

drerit risus eros eget felis. Maecenas eget erat in sapien mattis porttitor. Vestibulum

porttitor. Nulla facilisi. Sed a turpis eu lacus commodo facilisis. Morbi fringilla,

wisi in dignissim interdum, justo lectus sagittis dui, et vehicula libero dui cursus dui.

Mauris tempor ligula sed lacus. Duis cursus enim ut augue. Cras ac magna. Cras

nulla. Nulla egestas. Curabitur a leo. Quisque egestas wisi eget nunc. Nam feugiat

lacus vel est. Curabitur consectetuer.

A

Figure C.3: This is the caption for an image.

C.2.1.1 A Sub-Subsection

Suspendisse vel felis. Ut lorem lorem, interdum eu, tincidunt sit amet, laoreet vitae,

arcu. Aenean faucibus pede eu ante. Praesent enim elit, rutrum at, molestie non,

nonummy vel, nisl. Ut lectus eros, malesuada sit amet, fermentum eu, sodales cursus,

magna. Donec eu purus. Quisque vehicula, urna sed ultricies auctor, pede lorem

egestas dui, et convallis elit erat sed nulla. Donec luctus. Curabitur et nunc. Aliquam

dolor odio, commodo pretium, ultricies non, pharetra in, velit. Integer arcu est,

nonummy in, fermentum faucibus, egestas vel, odio.

Sed commodo posuere pede. Mauris ut est. Ut quis purus. Sed ac odio. Sed vehicula

hendrerit sem. Duis non odio. Morbi ut dui. Sed accumsan risus eget odio. In

hac habitasse platea dictumst. Pellentesque non elit. Fusce sed justo eu urna porta

tincidunt. Mauris felis odio, sollicitudin sed, volutpat a, ornare ac, erat. Morbi quis

dolor. Donec pellentesque, erat ac sagittis semper, nunc dui lobortis purus, quis

congue purus metus ultricies tellus. Proin et quam. Class aptent taciti sociosqu ad

litora torquent per conubia nostra, per inceptos hymenaeos. Praesent sapien turpis,

fermentum vel, eleifend faucibus, vehicula eu, lacus.

Pellentesque habitant morbi tristique senectus et netus et malesuada fames ac turpis

egestas. Donec odio elit, dictum in, hendrerit sit amet, egestas sed, leo. Praesent

feugiat sapien aliquet odio. Integer vitae justo. Aliquam vestibulum fringilla lorem.

Sed neque lectus, consectetuer at, consectetuer sed, eleifend ac, lectus. Nulla facilisi.

Pellentesque eget lectus. Proin eu metus. Sed porttitor. In hac habitasse platea

dictumst. Suspendisse eu lectus. Ut mi mi, lacinia sit amet, placerat et, mollis vitae,

dui. Sed ante tellus, tristique ut, iaculis eu, malesuada ac, dui. Mauris nibh leo,

facilisis non, adipiscing quis, ultrices a, dui.

Appendix D

CODE EXAMPLES

The following code listings are to demonstrate how code could be included in an

appendix.

Code Listing D.1: fibonacci.py

def fibonacci ( n: int ) -> int :
""" This function returns the nth Fibonacci number .""" if n == 0 or n == 1:
return n
else :
return fibonacci (n -1) + fibonacci (n -2)

Code Listing D.2: incmatrix.py

import numpy as np

def incmatrix ( genl1 , genl2 ) :
m = len ( genl1 )
n = len ( genl2 )
M = None # to become the incidence matrix
VT = np . zeros (( n *m ,1) , int ) # dummy variable

# compute the bitwise xor matrix

M1 = bitxormatrix ( genl1 )
M2 = np . triu ( bitxormatrix ( genl2 ) ,1)

for i in range (m -1) :
for j in range ( i +1 , m ) :
[r , c ] = np . where ( M2 == M1 [i , j ]) for k in range ( len ( r ) ) :
VT [( i ) * n + r [ k ]] = 1;
VT [( i ) * n + c [ k ]] = 1;
VT [( j ) * n + r [ k ]] = 1; VT [( j ) * n + c [ k ]] = 1;

if M is None :
M = np . copy ( VT )

else :
M = np . concatenate (( M , VT ) , 1)

VT = np . zeros (( n *m ,1) , int )

return M
