ahkar-kyaw/e_me599_Hermes/99_archive/Hermes_Thesis_Template/appendices/appendixB.tex

\chapter{Bill of Materials and Wiring}

% Add bill-of-materials, wiring, and connector tables here.
