ahkar-kyaw/e_me599_Hermes/99_archive/Hermes_Thesis_Template/appendices/appendixC.tex

\chapter{Controller and Firmware Configuration}

% Add communication, actuator, controller, and firmware settings here.
