ahkar-kyaw/e_me599_Hermes/99_archive/Hermes_Thesis_Template/chapters/chapter02.tex

\chapter{Background and Literature Review}

\section{Self-Balancing Mobile Robots}

\section{Inverted-Pendulum Dynamics}

\section{Mecanum Wheels and Omnidirectional Motion}

\section{State Estimation}

\section{Control Methods}

\section{Research Gap}
