ahkar-kyaw/e_me599_Hermes/99_archive/Hermes_Thesis_Template/chapters/chapter04.tex

\chapter{Mechanical Design}

\section{Mechanical Concept}

\section{Coordinate Frames and Wheel Layout}

\section{Chassis and Structural Design}

\section{Actuator and Wheel Integration}

\section{Center-of-Mass Design}

\section{Manufacturing and Assembly}
