ahkar-kyaw/e_me599_Hermes/99_archive/Hermes_Thesis_Template/chapters/chapter05.tex

\chapter{Electrical and Electronic Design}

\section{Electrical Architecture}

\section{Battery and Power Distribution}

\section{Controller and Sensors}

\section{Actuator Communication}

\section{Printed Circuit Board Design}

\section{Electrical Safety and Protection}
