ahkar-kyaw/e_me599_Hermes/99_archive/Hermes_Thesis_Template/chapters/chapter06.tex

\chapter{Kinematic and Dynamic Modeling}

\section{Coordinate Frames and Sign Conventions}

\section{Mecanum-Wheel Kinematics}

\section{Mobility and Rank Analysis}

\section{Dynamic Model}

\section{Linearization and State-Space Model}

\section{Modeling Assumptions and Limitations}
