ahkar-kyaw/e_me599_Hermes/99_archive/Hermes_Thesis_Template/chapters/chapter07.tex

\chapter{Control and State Estimation}

\section{Control Architecture}

\section{State Estimation}

\section{Balance Control}

\section{Translational and Yaw Control}

\section{Actuator Command Allocation}

\section{Discrete-Time Implementation}

\section{Saturation and Safety Limits}
