ahkar-kyaw/e_me599_Hermes/99_archive/Hermes_Thesis_Template/chapters/chapter08.tex

\chapter{Embedded Firmware and Software}

\section{Software Architecture}

\section{Initialization Sequence}

\section{Sensor Acquisition}

\section{Control-Loop Execution}

\section{Communication Interfaces}

\section{Telemetry and Data Logging}

\section{Fault Handling}
