ahkar-kyaw/e_me599_Hermes/99_archive/Hermes_Thesis_Template/chapters/chapter10.tex

\chapter{Prototype Integration and Experimental Methods}

\section{Mechanical and Electrical Integration}

\section{Sensor and Actuator Calibration}

\section{System Bring-Up}

\section{Test Equipment and Data Acquisition}

\section{Experimental Procedures}

\section{Safety Procedures}

\section{Measurement Uncertainty}
