ahkar-kyaw/e_me599_Hermes/99_archive/Hermes_Thesis_Template/chapters/chapter11.tex

\chapter{Results and Discussion}

\section{Simulation Results}

\section{Balancing Performance}

\section{Translational-Motion Performance}

\section{Lateral-Motion Performance}

\section{Yaw Performance}

\section{Embedded-System Performance}

\section{Requirement Verification}

\section{Limitations}
