ahkar-kyaw/e_me599_Hermes/99_archive/Zephyr_LaTeX_Thesis/appendices/appendixJ.tex

\chapter{Items Needed From the Author}\label{ch:items-needed-from-the-author}

Priority 1 items block defensible modeling, safety review, or
experimental claims. Priority 2 items are needed for a complete thesis
but do not prevent continued drafting. Priority 3 items improve
presentation and archival quality.

\clearpage
\begin{landscape}
\par\medskip\noindent\singlespacing
\phantomsection\addcontentsline{lot}{table}{\protect\numberline{J.1}Consolidated items needed from the author}
\textbf{Table J.1. Consolidated items needed from the author}\par

\begin{longtable}[]{@{}
  >{\raggedright\arraybackslash}p{(\columnwidth - 8\tabcolsep) * \real{0.0786}}
  >{\raggedright\arraybackslash}p{(\columnwidth - 8\tabcolsep) * \real{0.1143}}
  >{\raggedright\arraybackslash}p{(\columnwidth - 8\tabcolsep) * \real{0.3357}}
  >{\raggedright\arraybackslash}p{(\columnwidth - 8\tabcolsep) * \real{0.2429}}
  >{\raggedright\arraybackslash}p{(\columnwidth - 8\tabcolsep) * \real{0.2286}}@{}}
\toprule\noalign{}
\begin{minipage}[b]{\linewidth}\raggedright
\textbf{Priority}
\end{minipage} & \begin{minipage}[b]{\linewidth}\raggedright
\textbf{Chapter(s)}
\end{minipage} & \begin{minipage}[b]{\linewidth}\raggedright
\textbf{Item required}
\end{minipage} & \begin{minipage}[b]{\linewidth}\raggedright
\textbf{Why needed}
\end{minipage} & \begin{minipage}[b]{\linewidth}\raggedright
\textbf{Preferred evidence}
\end{minipage} \\
\midrule\noalign{}
\endhead
\bottomrule\noalign{}
\endlastfoot
1 & Front matter & Official degree\slash{}program, deadline month\slash{}year,
committee names\slash{}titles, copyright year & Template completion &
University\slash{}advisor confirmation \\
1 & 3--6 & Final wheel order, roller handedness, wheel coordinates,
balancing axis and sign conventions & Determines Jacobian rank and
command signs & Annotated as-built photo plus CAD\slash{}dimensions \\
1 & 4, 6, 9 & Total\slash{}body mass, COM, inertias, loaded radius, frame
geometry & Numerical dynamics and simulation & Measured record and CAD
report with uncertainty \\
1 & 5, 10 & Exact battery label\slash{}specification, protection, fuses,
wire\slash{}connectors, final schematic\slash{}PCB & Electrical safety and power
claims & Photographs, datasheets, KiCad release \\
1 & 5, 8, 10 & Installed controller\slash{}IMU\slash{}CAN hardware revisions and final
pin map & Reproducible interface record & Board labels, BOM, released
configuration \\
1 & 7, 8, 10 & Four actuator IDs, modes, direction signs, firmware,
limits, scaling, CAN definitions & Safe command generation &
Configuration dump and bench log \\
1 & 7--11 & Executed controller code, estimator\slash{}controller rates, gains,
filters, limits, state machine & Distinguishes plan from implementation
& Tagged commit and parameter file \\
1 & 9 & Final simulation scripts, parameters, solver settings, and raw
outputs & Reproducible simulation results & 05\_simulation ZIP\slash{}release
and README \\
1 & 10--12 & Raw synchronized tests for balance, disturbance, x\slash{}y\slash{}yaw,
timing, power, thermal, faults & Quantitative conclusions &
Machine-readable logs plus configuration manifests \\
1 & 10 & Approved risk assessment, E-stop\slash{}power isolation, test-area
procedure & Safe experimental authorization & Signed laboratory
document \\
2 & 1, 4 & Design rationale for collinear layout versus conventional
four-corner Mecanum & Motivation and tradeoff analysis & Author
narrative and dated design notes \\
2 & 4 & CAD renders, materials, bearings, shafts, couplings, fasteners,
assembly torque & Mechanical reproducibility & CAD\slash{}BOM\slash{}drawings \\
2 & 5 & PCB copper weight\slash{}stack-up, trace\slash{}via design, protection
selection, fabrication\slash{}bring-up results & Electrical verification &
Fabrication package and bench logs \\
2 & All & Final repository commit, all branches\slash{}tags, full history and
archived documentation & Traceability & Git bundle or ZIP plus git log
-\/-all \\
2 & 11 & Approved numerical performance requirements and acceptance
thresholds & Pass\slash{}fail conclusions & Advisor-approved requirement
baseline \\
2 & Front\slash{}12 & Acknowledgments, funding, disclosures, desired thesis
title & Submission completeness & Author text\slash{}confirmation \\
3 & All & Publication-quality photographs, diagrams, plots, editable
originals and permissions & Presentation quality &
CAD\slash{}KiCad\slash{}MATLAB\slash{}vector sources \\
3 & Appendices & Final BOM with costs\slash{}vendor revisions and calibration
certificates & Reproducibility and archive &
Spreadsheet\slash{}invoices\slash{}certificates \\
\end{longtable}
\end{landscape}
\clearpage
