ahkar-kyaw/e_me599_Hermes/99_archive/Zephyr_LaTeX_Thesis/frontmatter/abbreviations.tex

\clearpage
\chapter*{LIST OF ABBREVIATIONS, ACRONYMS, AND NOMENCLATURE}
\addcontentsline{toc}{chapter}{LIST OF ABBREVIATIONS, ACRONYMS, AND NOMENCLATURE}
\begin{longtable}{@{}p{1.25in}p{5.0in}@{}}
\toprule
\textbf{Term} & \textbf{Definition} \\
\midrule
\endfirsthead
\toprule
\textbf{Term} & \textbf{Definition} \\
\midrule
\endhead
ADC & Analog-to-digital converter \\
BLDC & Brushless direct-current \\
BMS & Battery-management system \\
CAN & Controller area network \\
COM & Center of mass \\
CRSF & Crossfire serial protocol \\
DMA & Direct memory access \\
DOF & Degree of freedom \\
E-stop & Emergency stop \\
FOC & Field-oriented control \\
IMU & Inertial measurement unit \\
LQR & Linear-quadratic regulator \\
MCU & Microcontroller unit \\
PCB & Printed circuit board \\
PID & Proportional-integral-derivative \\
RMS & Root mean square \\
RTOS & Real-time operating system \\
SPI & Serial peripheral interface \\
TWAI & Two-wire automotive interface, Espressif's CAN controller \\
UART & Universal asynchronous receiver-transmitter \\
WIP & Wheeled inverted pendulum \\
\bottomrule
\end{longtable}
