ahkar-kyaw/e_me599_Hermes/99_archive/Zephyr_LaTeX_Thesis/frontmatter/symbols.tex

\clearpage
\chapter*{LIST OF SYMBOLS}
\addcontentsline{toc}{chapter}{LIST OF SYMBOLS}
\begin{longtable}{@{}p{1.25in}p{5.0in}@{}}
\toprule
\textbf{Symbol} & \textbf{Definition and SI unit} \\
\midrule
\endfirsthead
\toprule
\textbf{Symbol} & \textbf{Definition and SI unit} \\
\midrule
\endhead
$A,B,C,D$ & State-space matrices \\
$b_x,b_\theta$ & Equivalent viscous damping coefficients, N$\cdot$s/m and N$\cdot$m$\cdot$s/rad \\
$E$ & Reduced mass matrix \\
$F_x,F_y$ & Body-frame generalized forces, N \\
$g$ & Gravitational acceleration, m/s$^2$ \\
$H$ & Wheel-to-body kinematic matrix \\
$I_p$ & Body pitch moment of inertia about its center of mass, kg$\cdot$m$^2$ \\
$K$ & Feedback-gain matrix \\
$\ell$ & Distance from the balancing axis to the body center of mass, m \\
$m_b$ & Body mass above the wheel axis, kg \\
$m_t$ & Equivalent translated mass, kg \\
$M_z$ & Yaw moment, N$\cdot$m \\
$q$ & Generalized-coordinate vector \\
$r$ & Effective wheel radius, m \\
$s_i$ & Roller-orientation sign of wheel $i$, dimensionless \\
$u$ & Control input \\
$v_x,v_y$ & Body-frame longitudinal and lateral velocities, m/s \\
$W$ & Positive-definite actuator-allocation weighting matrix \\
$x,y$ & Inertial-frame planar position, m \\
$y_i$ & Axial position of wheel $i$ in the body frame, m \\
$\alpha$ & Complementary-filter coefficient, dimensionless \\
$\theta$ & Pitch angle from the upright equilibrium, rad \\
$\tau_i$ & Wheel-$i$ actuator torque, N$\cdot$m \\
$\psi$ & Yaw angle, rad \\
$\omega_i$ & Wheel-$i$ angular velocity, rad/s \\
$\nu$ & Body twist $[v_x,v_y,\dot{\psi}]^T$ \\
\bottomrule
\end{longtable}
