ahkar-kyaw/e_me599_Hermes/99_archive/Hermes_Thesis_Template/main.pdf

DESIGN AND DEVELOPMENT OF HERMES: A SELF-BALANCING MOBILE

ROBOT WITH A COLLINEAR FOUR-WHEEL MECANUM DRIVE

A Thesis

Presented to

the Faculty of California Polytechnic State University, San Luis Obispo

In Partial Fulfillment

of the Requirements for the Degree

DEGREE NAME

by

Ahkar Kyaw

MONTH YEAR

© YEAR

Ahkar Kyaw

ALL RIGHTS RESERVED

ii

COMMITTEE MEMBERSHIP

TITLE: | Design and Development of Hermes: A Self-Balancing Mobile
| Robot with a Collinear Four-Wheel Mecanum Drive
AUTHOR: | Ahkar Kyaw
DATE SUBMITTED: | MONTH YEAR
COMMITTEE CHAIR: | COMMITTEE CHAIR NAME
| COMMITTEE CHAIR TITLE
COMMITTEE MEMBER: | COMMITTEE MEMBER NAME
| COMMITTEE MEMBER TITLE
COMMITTEE MEMBER: | COMMITTEE MEMBER NAME
| COMMITTEE MEMBER TITLE

iii

ABSTRACT

iv

ACKNOWLEDGMENTS

v

# Contents

vi

# List of Tables

vii

# List of Figures

viii

LIST OF SYMBOLS

Symbol | Definition | Unit

ix

LIST OF ABBREVIATIONS

Abbreviation | Definition

x

Chapter 1

INTRODUCTION

### 1.1 Background and Motivation

### 1.2 Problem Statement

### 1.3 Research Objectives

### 1.4 Research Questions

### 1.5 Scope and Limitations

### 1.6 Thesis Organization

1

Chapter 2

BACKGROUND AND LITERATURE REVIEW

### 2.1 Self-Balancing Mobile Robots

### 2.2 Inverted-Pendulum Dynamics

### 2.3 Mecanum Wheels and Omnidirectional Motion

### 2.4 State Estimation

### 2.5 Control Methods

### 2.6 Research Gap

2

Chapter 3

SYSTEM REQUIREMENTS AND ARCHITECTURE

### 3.1 Functional Requirements

### 3.2 Performance Requirements

### 3.3 System Architecture

### 3.4 Subsystem Interfaces

### 3.5 Design Tradeoffs

### 3.6 Verification Plan

3

Chapter 4

MECHANICAL DESIGN

### 4.1 Mechanical Concept

### 4.2 Coordinate Frames and Wheel Layout

### 4.3 Chassis and Structural Design

### 4.4 Actuator and Wheel Integration

### 4.5 Center-of-Mass Design

### 4.6 Manufacturing and Assembly

4

Chapter 5

ELECTRICAL AND ELECTRONIC DESIGN

### 5.1 Electrical Architecture

### 5.2 Battery and Power Distribution

### 5.3 Controller and Sensors

### 5.4 Actuator Communication

### 5.5 Printed Circuit Board Design

### 5.6 Electrical Safety and Protection

5

Chapter 6

KINEMATIC AND DYNAMIC MODELING

### 6.1 Coordinate Frames and Sign Conventions

### 6.2 Mecanum-Wheel Kinematics

### 6.3 Mobility and Rank Analysis

### 6.4 Dynamic Model

### 6.5 Linearization and State-Space Model

### 6.6 Modeling Assumptions and Limitations

6

Chapter 7

CONTROL AND STATE ESTIMATION

### 7.1 Control Architecture

### 7.2 State Estimation

### 7.3 Balance Control

### 7.4 Translational and Yaw Control

### 7.5 Actuator Command Allocation

### 7.6 Discrete-Time Implementation

### 7.7 Saturation and Safety Limits

7

Chapter 8

EMBEDDED FIRMWARE AND SOFTWARE

### 8.1 Software Architecture

### 8.2 Initialization Sequence

### 8.3 Sensor Acquisition

### 8.4 Control-Loop Execution

### 8.5 Communication Interfaces

### 8.6 Telemetry and Data Logging

### 8.7 Fault Handling

8

Chapter 9

SIMULATION AND ANALYSIS

### 9.1 Simulation Objectives

### 9.2 Model Implementation

### 9.3 Parameters and Initial Conditions

### 9.4 Numerical Methods

### 9.5 Simulation Cases

### 9.6 Analysis Methods

9

Chapter 10

PROTOTYPE INTEGRATION AND EXPERIMENTAL METHODS

### 10.1 Mechanical and Electrical Integration

### 10.2 Sensor and Actuator Calibration

### 10.3 System Bring-Up

### 10.4 Test Equipment and Data Acquisition

### 10.5 Experimental Procedures

### 10.6 Safety Procedures

### 10.7 Measurement Uncertainty

10

Chapter 11

RESULTS AND DISCUSSION

### 11.1 Simulation Results

### 11.2 Balancing Performance

### 11.3 Translational-Motion Performance

### 11.4 Lateral-Motion Performance

### 11.5 Yaw Performance

### 11.6 Embedded-System Performance

### 11.7 Requirement Verification

### 11.8 Limitations

11

Chapter 12

CONCLUSIONS AND FUTURE WORK

### 12.1 Conclusions

### 12.2 Contributions

### 12.3 Remaining Limitations

### 12.4 Future Work

12

REFERENCES

13

Chapter A

SYSTEM PARAMETERS

14

Chapter B

BILL OF MATERIALS AND WIRING

15

Chapter C

CONTROLLER AND FIRMWARE CONFIGURATION

16

Chapter D

TEST PROCEDURES AND SUPPLEMENTARY RESULTS

17
