ahkar-kyaw/e_me599_Hermes/99_archive/Zephyr_LaTeX_Thesis/appendices/appendixL.tex

\chapter{Consistency and Compliance Report}\label{ch:consistency-and-compliance-report}

This report describes the first-draft state, not final university
approval. Page numbers, lists, and pagination were regenerated after
document layout; they should be refreshed again after the author
replaces placeholders.

\par\medskip\noindent\singlespacing
\phantomsection\addcontentsline{lot}{table}{\protect\numberline{L.1}Final consistency and compliance review}
\textbf{Table L.1. Final consistency and compliance review}\par

\begin{longtable}[]{@{}
  >{\raggedright\arraybackslash}p{(\columnwidth - 6\tabcolsep) * \real{0.1773}}
  >{\raggedright\arraybackslash}p{(\columnwidth - 6\tabcolsep) * \real{0.3617}}
  >{\raggedright\arraybackslash}p{(\columnwidth - 6\tabcolsep) * \real{0.3050}}
  >{\raggedright\arraybackslash}p{(\columnwidth - 6\tabcolsep) * \real{0.1560}}@{}}
\toprule\noalign{}
\begin{minipage}[b]{\linewidth}\raggedright
\textbf{Check}
\end{minipage} & \begin{minipage}[b]{\linewidth}\raggedright
\textbf{Draft finding}
\end{minipage} & \begin{minipage}[b]{\linewidth}\raggedright
\textbf{Remaining action}
\end{minipage} & \begin{minipage}[b]{\linewidth}\raggedright
\textbf{Owner\slash{}review}
\end{minipage} \\
\midrule\noalign{}
\endhead
\bottomrule\noalign{}
\endlastfoot
Template compliance & Uses supplied Fall 2026 template as base; Letter
size; 1-in margins; Times New Roman 12 pt body; double-spaced body;
required front matter\slash{}order; chapter starts & Insert official
front-matter data; final university\slash{}advisor format review &
Author\slash{}graduate coordinator \\
Objective-to-conclusion alignment & Conclusions limited to architecture,
subsystem evidence, and symbolic analysis; performance claims withheld &
Populate results and revise abstract\slash{}conclusions only from verified
tests & Author\slash{}advisor \\
Requirement-to-test traceability & Tables 3.1, 10.1, and 11.2 map draft
requirements to methods\slash{}results & Approve quantitative criteria and
execute protocols & Author\slash{}advisor \\
Symbols and units & SI system used; primary symbols listed; pitch\slash{}yaw
and wheel signs parameterized & Freeze coordinate\slash{}sign convention and
add measured uncertainties & Author \\
Figure\slash{}table numbering & Chapter-based numbering and lists generated
consistently; appendix tables lettered & Refresh after insertions and
verify no split captions & Author\slash{}editor \\
Equation numbering & Chapter-based numbering; symbols defined near use
or in symbol list & Recheck signs\slash{}dimensions with measured geometry; add
appendix equations if expanded & Author\slash{}advisor \\
Citation\slash{}reference matching & References \cite{zephyr_repo}--\cite{chacko2023trajectory} are cited and
each citation has an entry; primary\slash{}official sources prioritized &
Reverify final revisions, page ranges, and repository commit &
Author\slash{}librarian \\
Unsupported claims & Implementation, plan, and test status explicitly
separated; quantitative claims use placeholders & Audit any author
replacement text and final captions & Author\slash{}advisor \\
Remaining placeholders & Front matter, hardware measurements, design
rationale, figures, numerical parameters, gains, simulation outputs,
experiments, results & Resolve Appendix J in priority order & Author \\
Advisor review & Novelty framing is cautious; collinear rank and
balance\slash{}control interaction are central & Review thesis scope,
theoretical simplifications, requirements, safety, and conclusion
strength & Committee \\
Accessibility & Black text, descriptive captions, table headers, and
equation alternative descriptions included & Run final accessibility
checker; add alt text to inserted figures & Author\slash{}editor \\
Repository reproducibility & Paths cited where evidence was available;
access limitations recorded & Archive final repo, history, raw data, and
release manifest & Author \\
\end{longtable}
