ahkar-kyaw/e_me599_Hermes/99_archive/Zephyr_LaTeX_Thesis/config/metadata.tex

\newcommand{\ThesisTitle}{Design and Development of a Self-Balancing Mobile Robot with a Collinear Four-Wheel Mecanum Drive}
\newcommand{\ThesisAuthor}{Ahkar Kyaw}
\newcommand{\DegreeName}{\authorinput{Official degree title and program title}}
\newcommand{\SubmissionDate}{\authorinput{Publication deadline month and year}}
\newcommand{\CopyrightYear}{\authorinput{Year submitted}}
\newcommand{\CommitteeChairName}{\authorinput{Committee chair full name and degree}}
\newcommand{\CommitteeChairTitle}{\authorinput{Committee chair faculty title}}
\newcommand{\CommitteeMemberOneName}{\authorinput{Committee member full name and degree}}
\newcommand{\CommitteeMemberOneTitle}{\authorinput{Committee member faculty title}}
\newcommand{\CommitteeMemberTwoName}{\authorinput{Committee member full name and degree}}
\newcommand{\CommitteeMemberTwoTitle}{\authorinput{Committee member faculty title}}
