ahkar-kyaw/e_me599_Hermes/02_mechanical/00_SW2023-Hermes/3421-0014-0060/3421-0014-0060 assembly.STEP

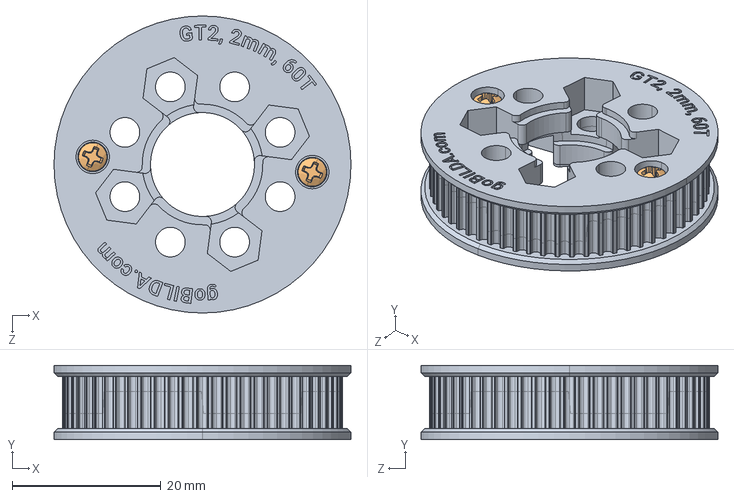
[picture p1: CAD file, 2026-09-27]
02_mechanical/00_SW2023-Hermes/3421-0014-0060/3421-0014-0060 assembly.STEP
40.0 x 10.0 x 40.0 mm
3421-0014-0060 screw x 4
