ahkar-kyaw/e_me599_Hermes/02_mechanical/00_SW2023-Hermes/12-goBILDA-2106 Series 8mm REX e-clip.SLDASM.SLDPRT

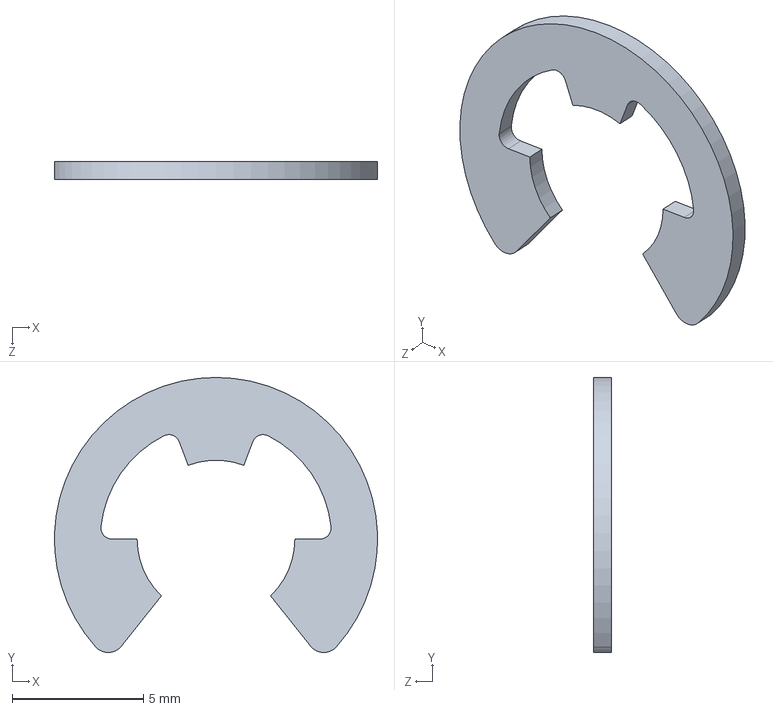
[picture p2: CAD file, 2026-09-27]
02_mechanical/00_SW2023-Hermes/12-goBILDA-2106 Series 8mm REX e-clip.SLDASM.SLDPRT
12.3 x 10.5 x 0.7 mm
