ahkar-kyaw/e_me599_Hermes/02_mechanical/00_SW2023-Hermes/11-goBILDA-1309-0016-4008.SLDASM

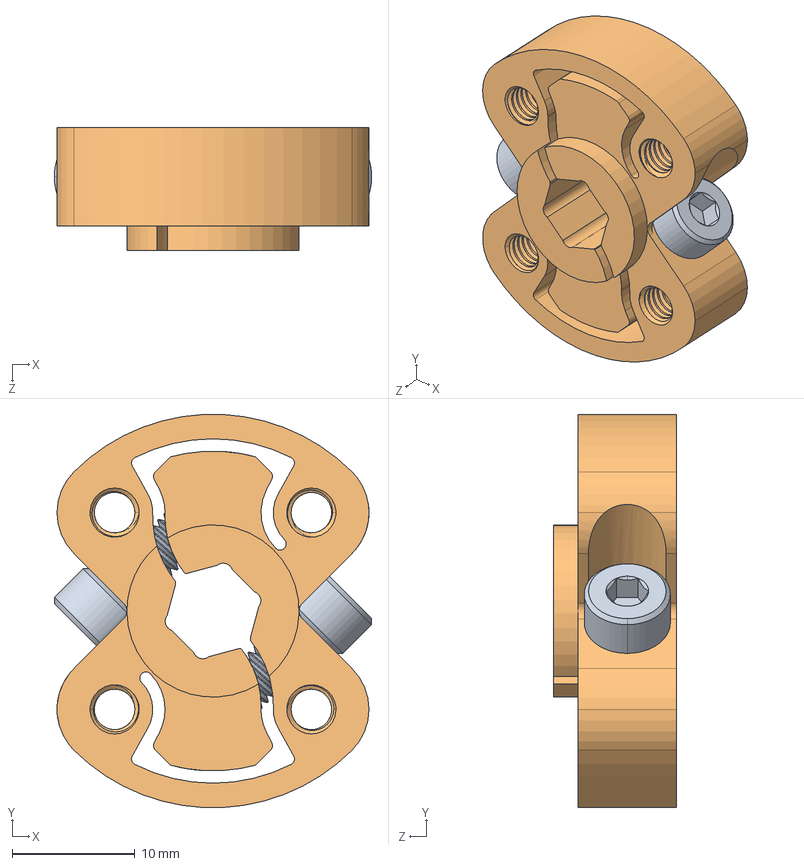
[picture p3: CAD file, 2026-09-27]
02_mechanical/00_SW2023-Hermes/11-goBILDA-1309-0016-4008.SLDASM
25.8 x 32.0 x 10.0 mm
12-goBILDA-1309-0016-4008
12-goBILDA-2800-0004-0014_90128A207 x 2
