ahkar-kyaw/e_me599_Hermes/02_mechanical/00_SW2023-Hermes/11-goBILDA-3421-0014-0060.SLDASM

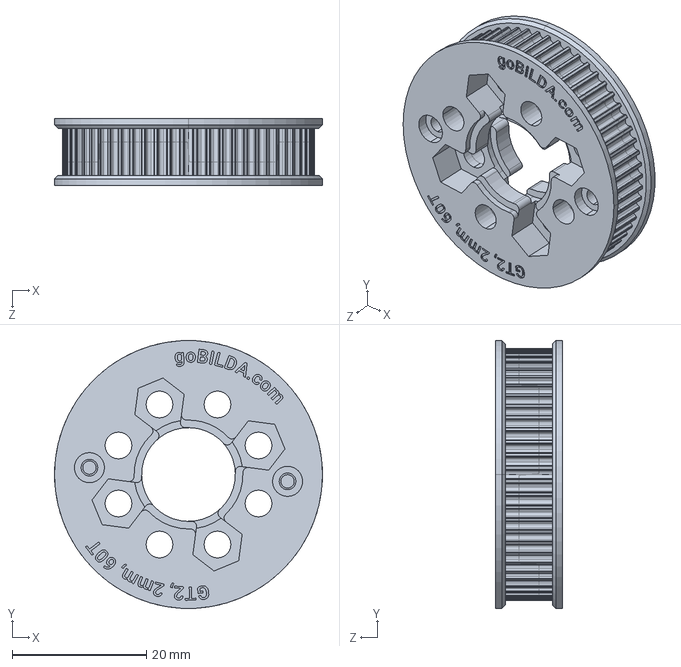
[picture p4: CAD file, 2026-09-27]
02_mechanical/00_SW2023-Hermes/11-goBILDA-3421-0014-0060.SLDASM
40.0 x 40.0 x 10.00 mm
12-goBILDA-3421-0014-0060 x 2
