ahkar-kyaw/e_me599_Hermes/02_mechanical/00_SW2023-Hermes/11-goBILDA-2106-4008-1920.SLDASM

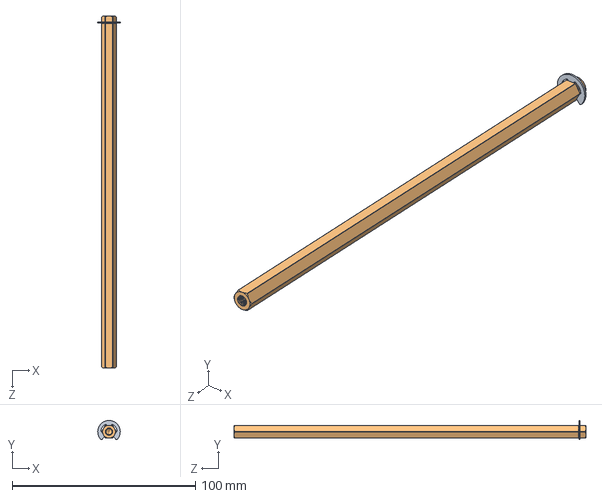
[picture p5: CAD file, 2026-09-27]
02_mechanical/00_SW2023-Hermes/11-goBILDA-2106-4008-1920.SLDASM
12.3 x 10.5 x 192.0 mm
12-goBILDA-2106-4008-1920
12-goBILDA-2106 Series 8mm REX e-clip.SLDASM
