ahkar-kyaw/e_me599_Hermes/02_mechanical/00_SW2023-Hermes/00_Zephyr_SW2023.SLDASM

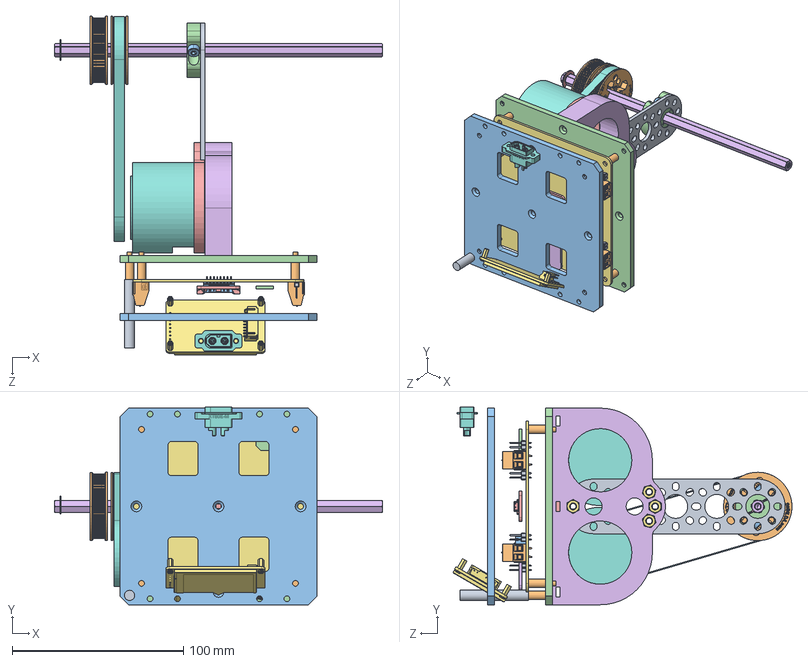
[picture p6: CAD file, 2026-09-27]
02_mechanical/00_SW2023-Hermes/00_Zephyr_SW2023.SLDASM
192.0 x 115.5 x 198.2 mm
12-CubeMars-AK40-10-V2-KV170 x 2
22-PCB
12-Adafruit-CanPal
12-Adafruit-ISM330DHXC
12-Radiomaster-RP2
12-JST-B8B-PH-K-S
12-PhoenixContact-1715721 x 4
12_HeaderPin x 4
12-XT60E-M
12-Waveshare-LCD-2inch-Module
12-goBILDA-2106-4008-1920
12-goBILDA-2106 Series 8mm REX e-clip.SLDASM
12-goBILDA-1309-0016-4008
12-goBILDA-2800-0004-0014_90128A207 x 2
12-goBILDA-3421-0014-0060 x 4
12-goBILDA-1105-0005-0128
12-goBILDA-3423-0006-0312
12-goBILDA-1516-4008-0160 x 4
22-Mount-Actuator-4
22-Mount-Actuator-5
22-Mount-Actuator-6
22-Mount-Actuator-7
12-Patikil-Standoff-M3x10-6mm x 5
12-Patikil-Standoff-M3x20-6mm
