ahkar-kyaw/e_me599_Hermes/02_mechanical/00_SW2023-Hermes/11_Actuator.SLDASM

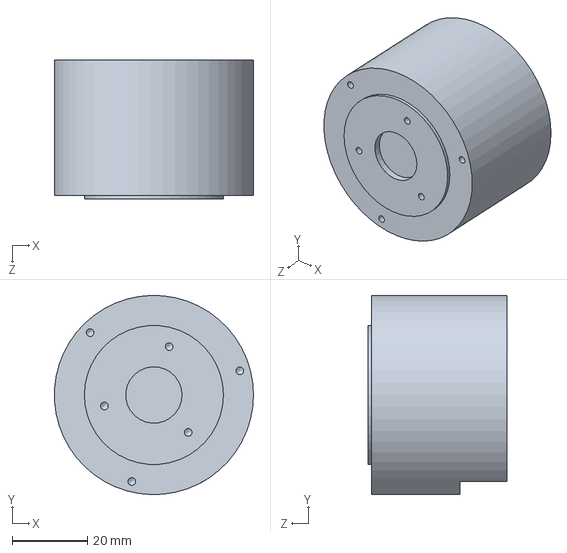
[picture p7: CAD file, 2026-09-27]
02_mechanical/00_SW2023-Hermes/11_Actuator.SLDASM
52.9 x 53.0 x 37.0 mm
