ahkar-kyaw/e_me599_Hermes/02_mechanical/00_SW2023-Hermes/12-goBILDA-3421-0014-0060.SLDPRT

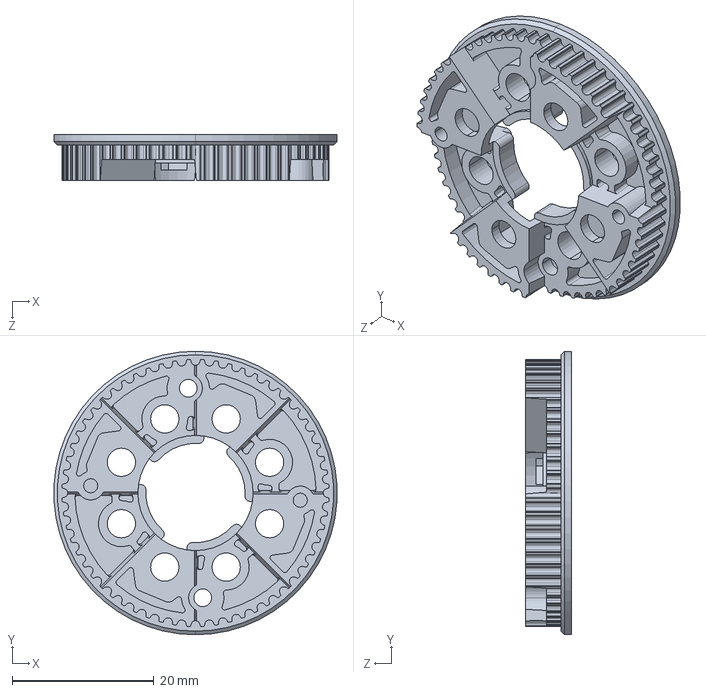
[picture p8: CAD file, 2026-09-27]
02_mechanical/00_SW2023-Hermes/12-goBILDA-3421-0014-0060.SLDPRT
39.9 x 40.0 x 6.50 mm
