ahkar-kyaw/e_me599_Hermes/02_mechanical/00_SW2023-Hermes/3625-0202-0104/3625-0001-0104.step

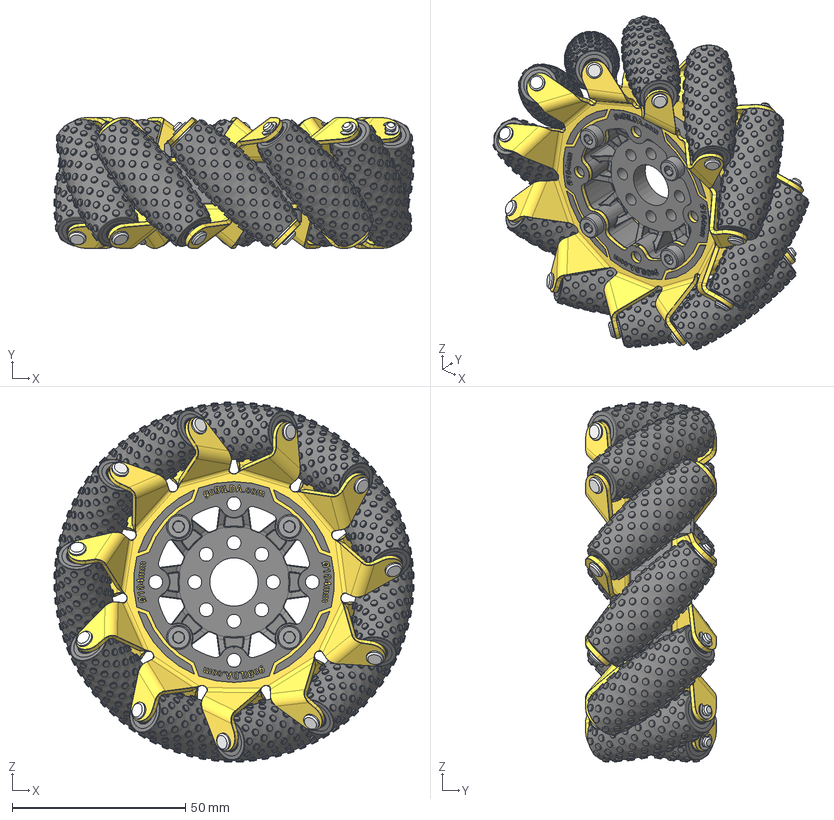
[picture p9: CAD file, 2026-09-27]
02_mechanical/00_SW2023-Hermes/3625-0202-0104/3625-0001-0104.step
104.0 x 37.8 x 104.0 mm
RollerCore x 11
RollerTire x 11
Shim x 22
Pin x 11
OR x 22
IR x 22
Core
2800-0004-0020 v7 x 4
2812-0004-0007 v10 x 4
PAINT x 2
