ahkar-kyaw/e_me599_Hermes/02_mechanical/00_SW2023-Hermes/12-goBILDA-2106-4008-1920.SLDPRT

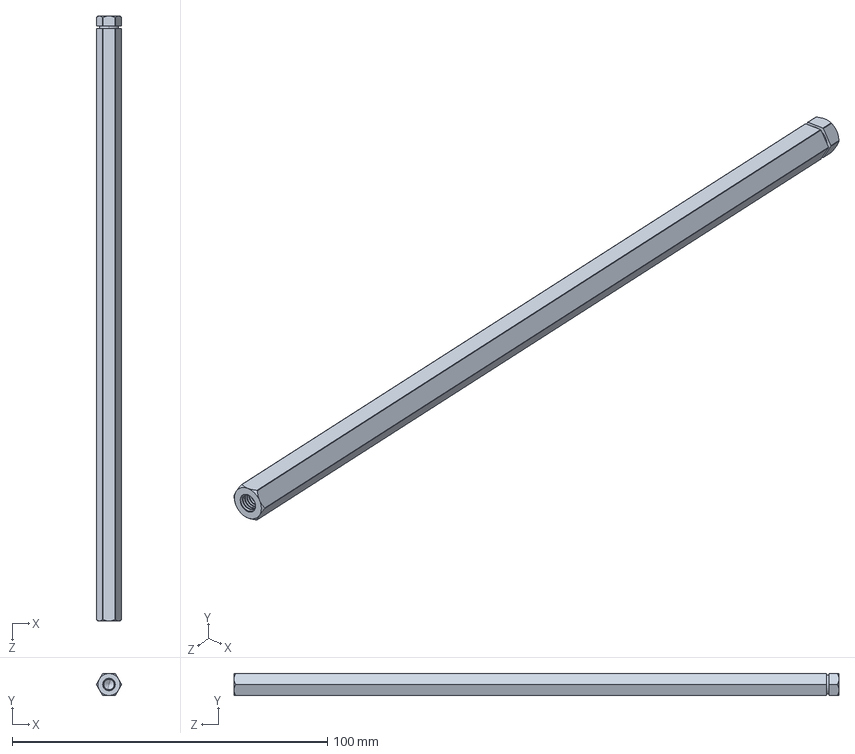
[picture p10: CAD file, 2026-09-27]
02_mechanical/00_SW2023-Hermes/12-goBILDA-2106-4008-1920.SLDPRT
8.00 x 7.00 x 192.0 mm
