ahkar-kyaw/e_me599_Hermes/02_mechanical/00_SW2023-Hermes/22-Mount-Actuator-6.SLDPRT

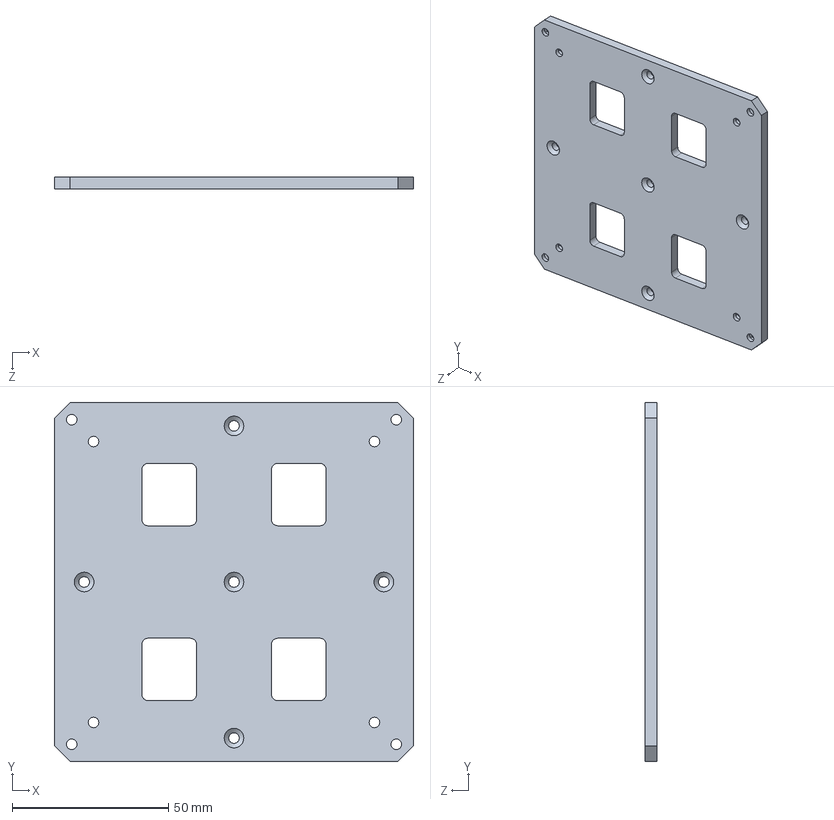
[picture p11: CAD file, 2026-09-27]
02_mechanical/00_SW2023-Hermes/22-Mount-Actuator-6.SLDPRT
115.0 x 115.0 x 4.00 mm
