ahkar-kyaw/e_me599_Hermes/02_mechanical/00_SW2023-Hermes/JST-B8B-PH-K-S.STEP

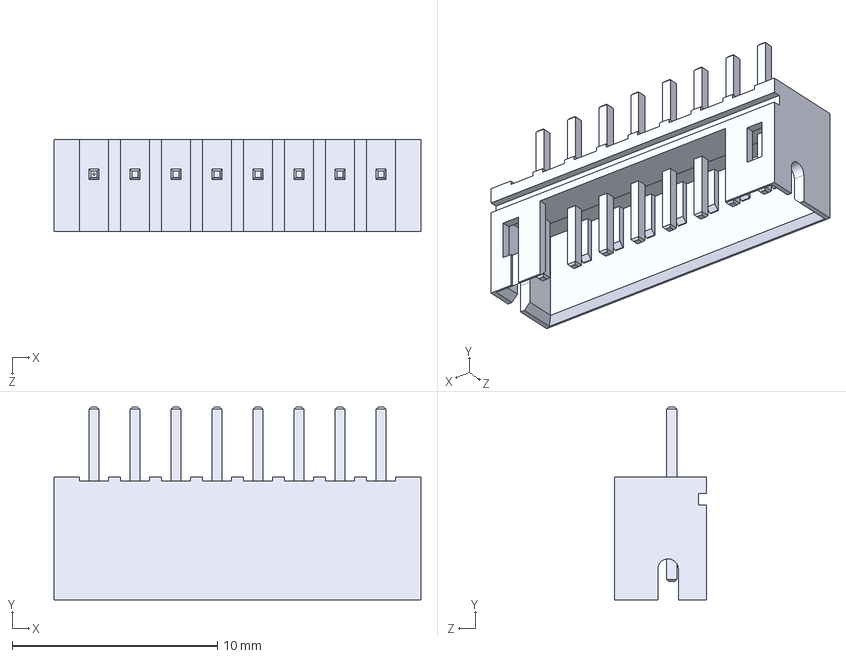
[picture p12: CAD file, 2026-09-27]
02_mechanical/00_SW2023-Hermes/JST-B8B-PH-K-S.STEP
17.9 x 9.40 x 4.50 mm
