ahkar-kyaw/e_me599_Hermes/02_mechanical/00_SW2023-Hermes/12-goBILDA-1516-4008-0160.SLDPRT

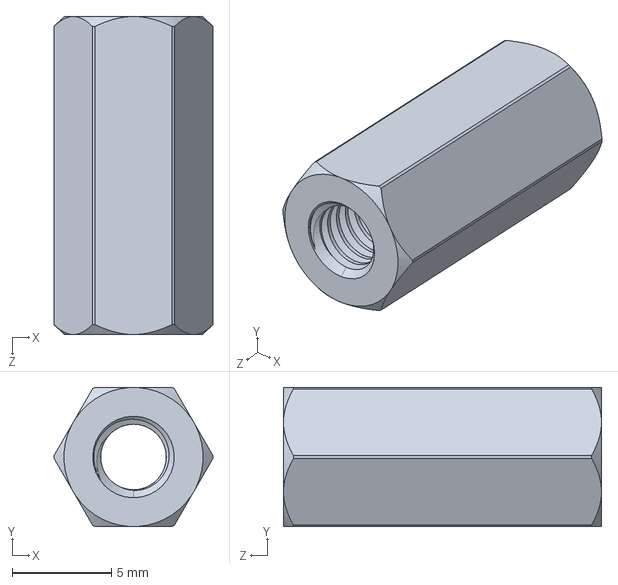
[picture p13: CAD file, 2026-09-27]
02_mechanical/00_SW2023-Hermes/12-goBILDA-1516-4008-0160.SLDPRT
8.00 x 7.00 x 16.0 mm
