ahkar-kyaw/e_me599_Hermes/02_mechanical/00_SW2023-Hermes/12-Patikil-Standoff-M4x40-6mm.SLDPRT

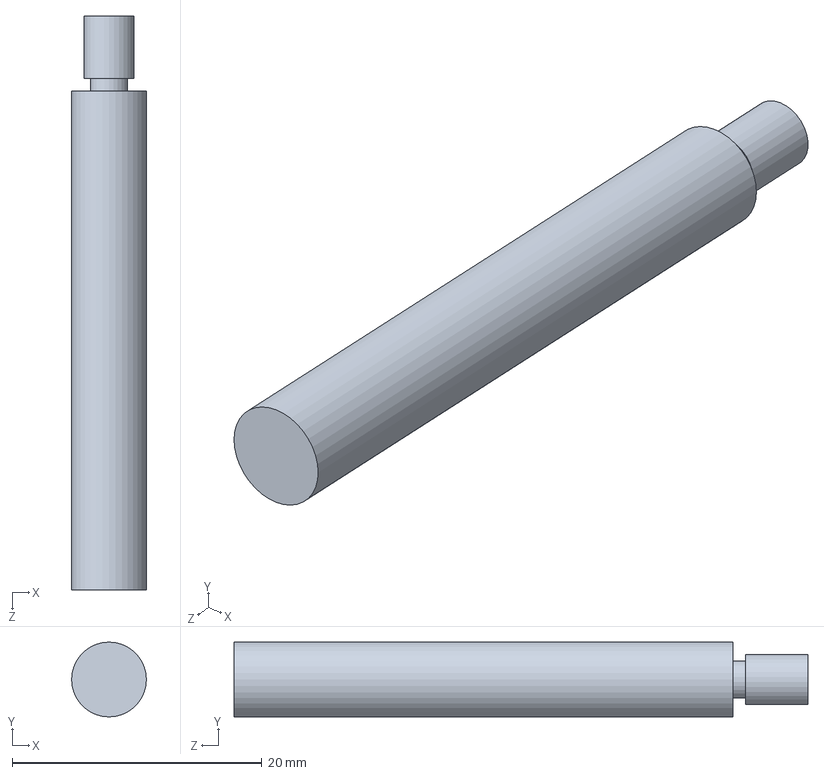
[picture p14: CAD file, 2026-09-27]
02_mechanical/00_SW2023-Hermes/12-Patikil-Standoff-M4x40-6mm.SLDPRT
6.00 x 6.00 x 46.0 mm
