ahkar-kyaw/e_me599_Hermes/02_mechanical/00_SW2023-Hermes/12_HeaderPin.SLDPRT

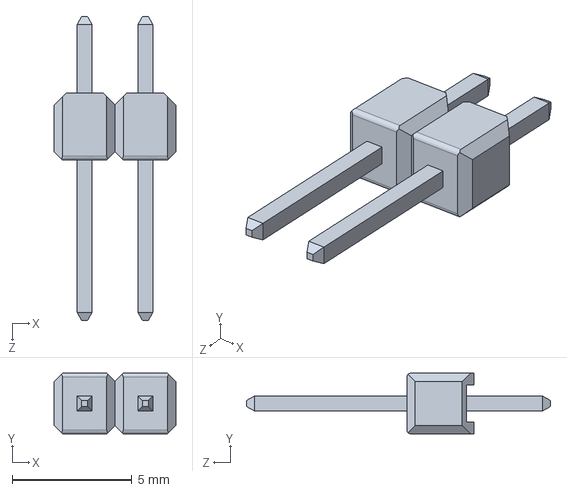
[picture p15: CAD file, 2026-09-27]
02_mechanical/00_SW2023-Hermes/12_HeaderPin.SLDPRT
5.08 x 2.54 x 12.7 mm
