ahkar-kyaw/e_me599_Hermes/02_mechanical/00_SW2023-Hermes/12-Adafruit-CanPal.SLDPRT

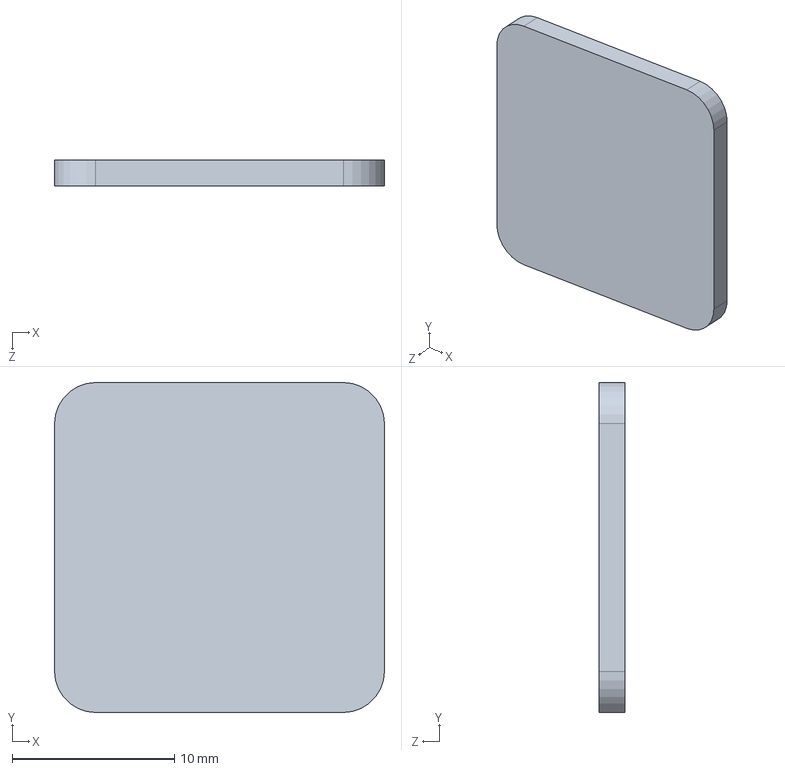
[picture p16: CAD file, 2026-09-27]
02_mechanical/00_SW2023-Hermes/12-Adafruit-CanPal.SLDPRT
20.3 x 20.3 x 1.60 mm
