ahkar-kyaw/e_me599_Hermes/02_mechanical/00_SW2023-Hermes/12-goBILDA-2800-0004-0014_90128A207.SLDPRT

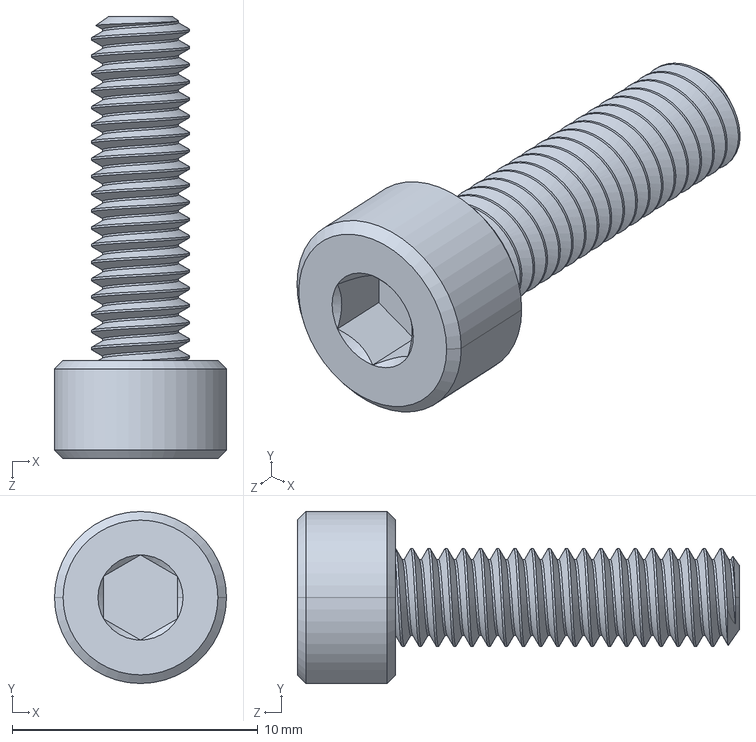
[picture p17: CAD file, 2026-09-27]
02_mechanical/00_SW2023-Hermes/12-goBILDA-2800-0004-0014_90128A207.SLDPRT
7.00 x 7.00 x 18.0 mm
