ahkar-kyaw/e_me599_Hermes/02_mechanical/00_SW2023-Hermes/22-Mount-Actuator-1.SLDPRT

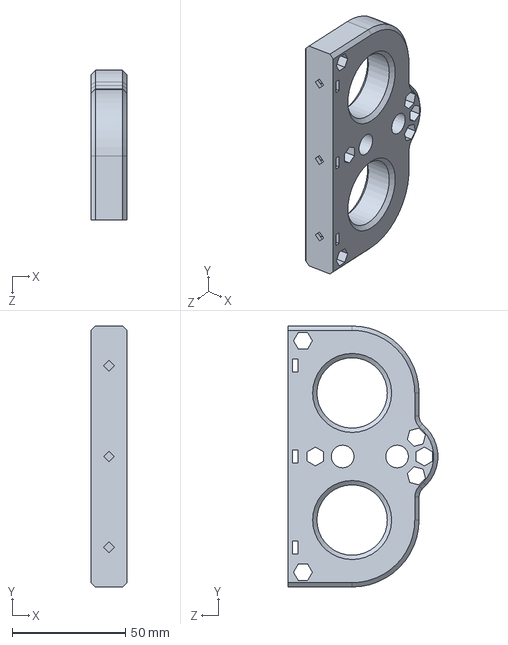
[picture p18: CAD file, 2026-09-27]
02_mechanical/00_SW2023-Hermes/22-Mount-Actuator-1.SLDPRT
15.8 x 115.0 x 65.9 mm
