ahkar-kyaw/e_me599_Hermes/02_mechanical/00_SW2023-Hermes/12-goBILDA-3423-0006-0312.SLDPRT

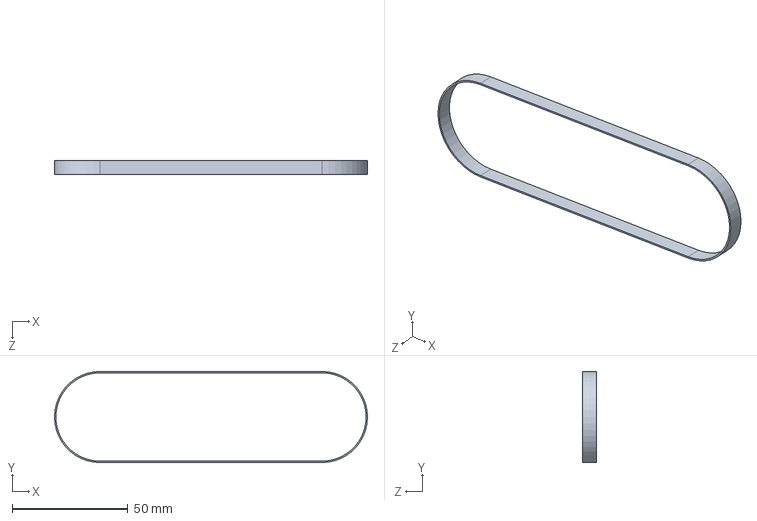
[picture p19: CAD file, 2026-09-27]
02_mechanical/00_SW2023-Hermes/12-goBILDA-3423-0006-0312.SLDPRT
135.4 x 39.4 x 6.00 mm
