ahkar-kyaw/e_me599_Hermes/02_mechanical/00_SW2023-Hermes/12-NodeMCU-ESP32-Wroom32s.SLDPRT

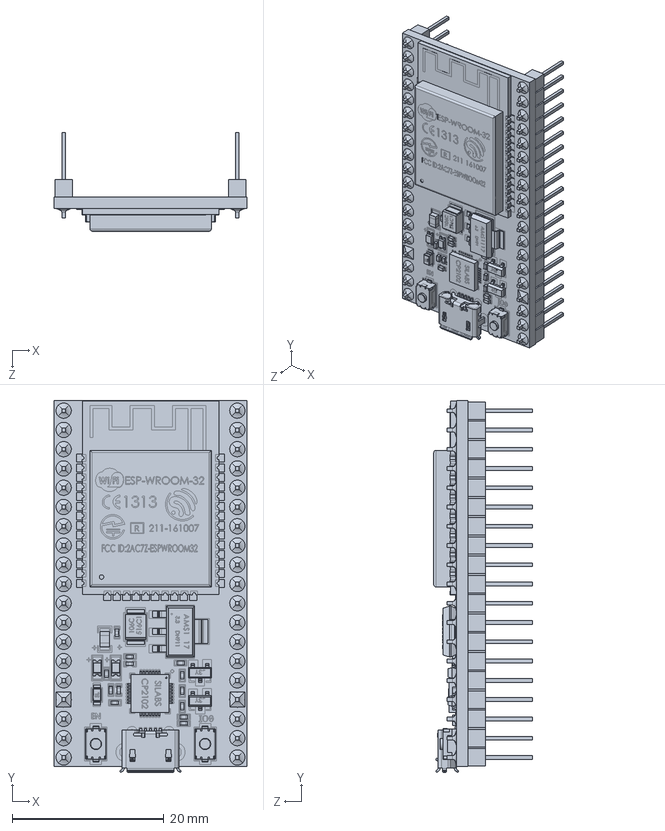
[picture p20: CAD file, 2026-09-27]
02_mechanical/00_SW2023-Hermes/12-NodeMCU-ESP32-Wroom32s.SLDPRT
25.4 x 49.0 x 13.0 mm
