ahkar-kyaw/e_me599_Hermes/02_mechanical/00_SW2023-Hermes/22-Mount-Actuator-2.SLDPRT

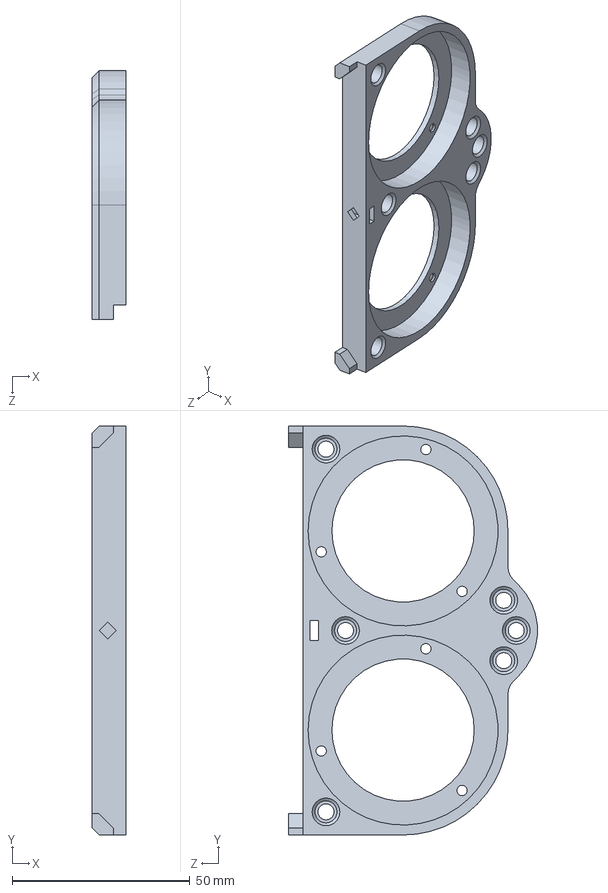
[picture p21: CAD file, 2026-09-27]
02_mechanical/00_SW2023-Hermes/22-Mount-Actuator-2.SLDPRT
9.60 x 115.0 x 69.9 mm
