ahkar-kyaw/e_me599_Hermes/02_mechanical/00_SW2023-Hermes/22-PCB.SLDPRT

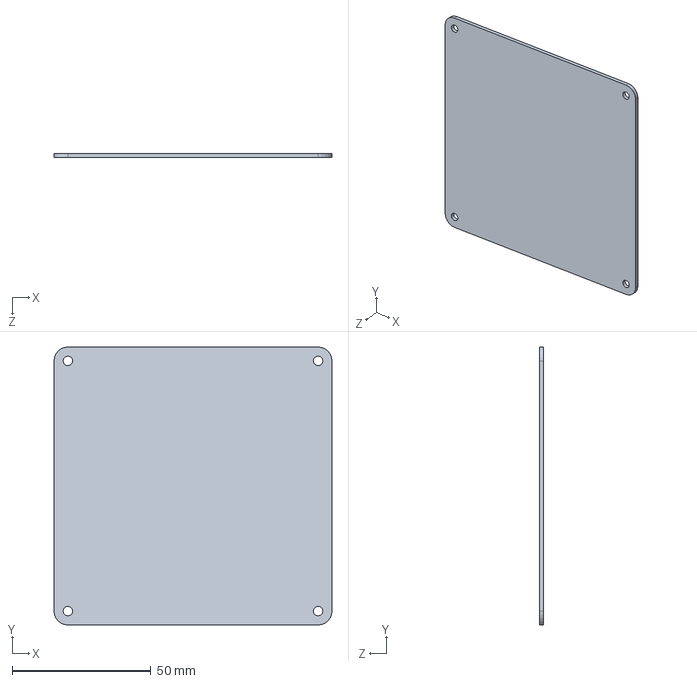
[picture p22: CAD file, 2026-09-27]
02_mechanical/00_SW2023-Hermes/22-PCB.SLDPRT
100.0 x 100.0 x 1.60 mm
