ahkar-kyaw/e_me599_Hermes/02_mechanical/00_SW2023-Hermes/1105-0005-0128.STEP

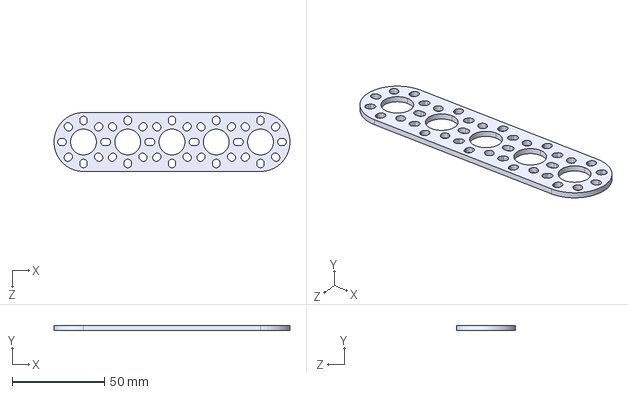
[picture p23: CAD file, 2026-09-27]
02_mechanical/00_SW2023-Hermes/1105-0005-0128.STEP
128.0 x 2.50 x 32.0 mm
