ahkar-kyaw/e_me599_Hermes/02_mechanical/00_SW2023-Hermes/Adafruit_ISM330DHXC.STEP

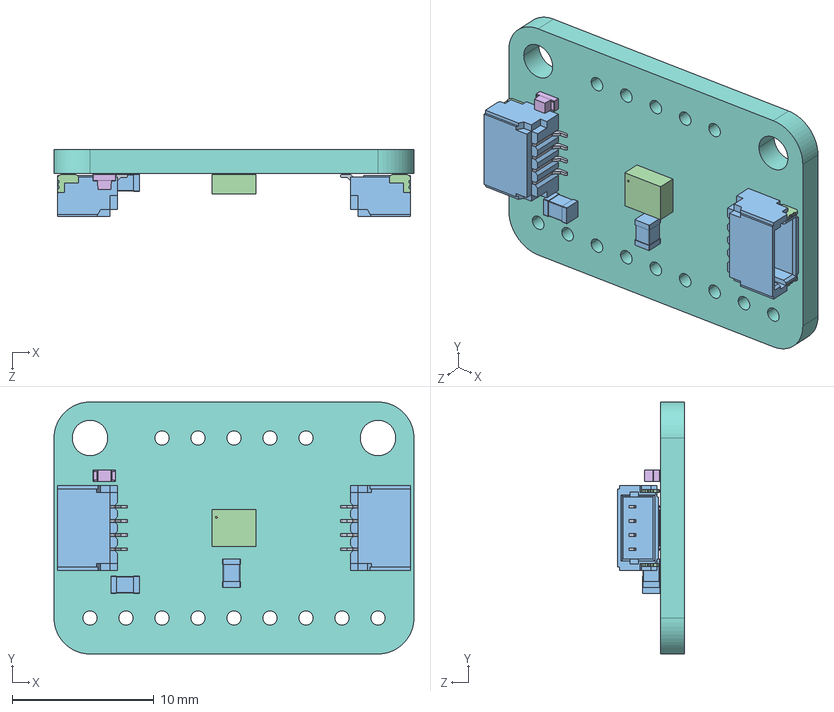
[picture p24: CAD file, 2026-09-27]
02_mechanical/00_SW2023-Hermes/Adafruit_ISM330DHXC.STEP
25.4 x 17.8 x 4.73 mm
