ahkar-kyaw/e_me599_Hermes/02_mechanical/00_SW2023-Hermes/12-Waveshare-LCD-2inch-Module.SLDPRT

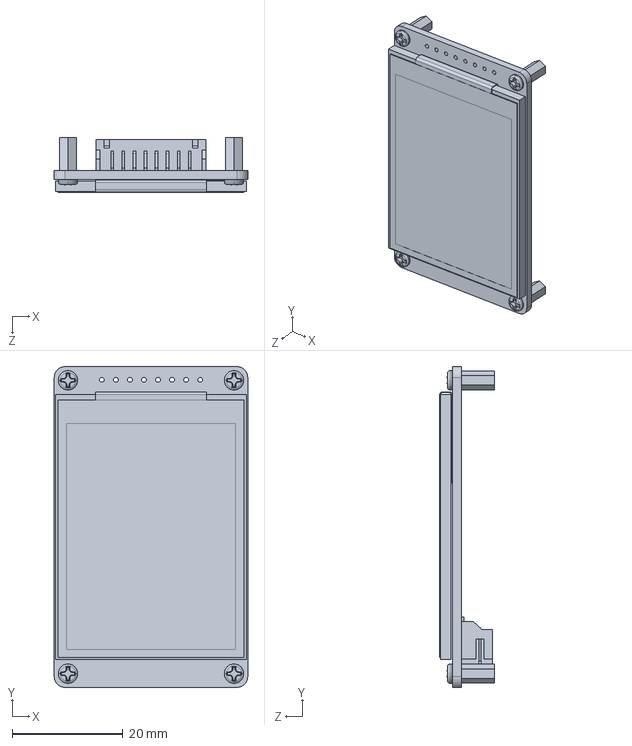
[picture p25: CAD file, 2026-09-27]
02_mechanical/00_SW2023-Hermes/12-Waveshare-LCD-2inch-Module.SLDPRT
35.0 x 58.0 x 10.0 mm
