ahkar-kyaw/e_me599_Hermes/02_mechanical/00_SW2023-Hermes/1611-0514-4008.STEP

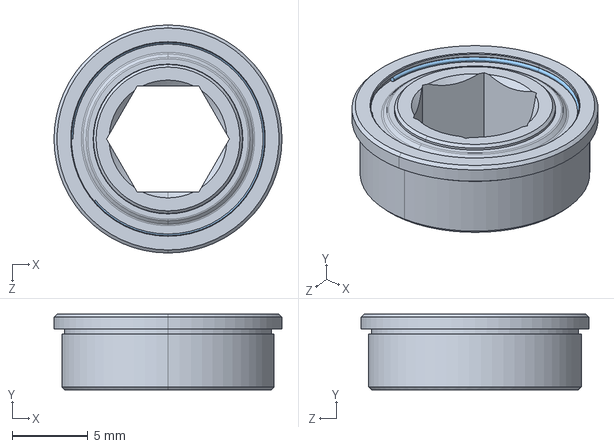
[picture p26: CAD file, 2026-09-27]
02_mechanical/00_SW2023-Hermes/1611-0514-4008.STEP
15.0 x 5.00 x 15.0 mm
