ahkar-kyaw/e_me599_Hermes/02_mechanical/00_SW2023-Hermes/22-Mount-Actuator-5.SLDPRT

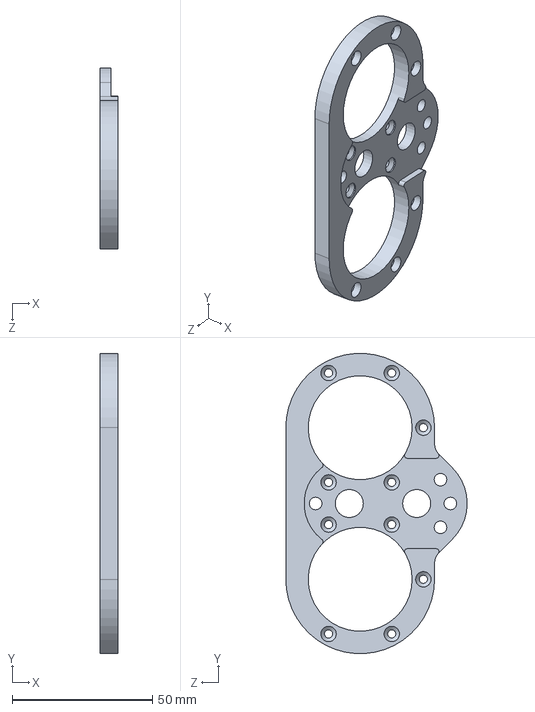
[picture p27: CAD file, 2026-09-27]
02_mechanical/00_SW2023-Hermes/22-Mount-Actuator-5.SLDPRT
6.30 x 106.9 x 64.6 mm
