ahkar-kyaw/e_me599_Hermes/02_mechanical/00_SW2023-Hermes/12-Patikil-Standoff-M3x10-6mm.SLDPRT

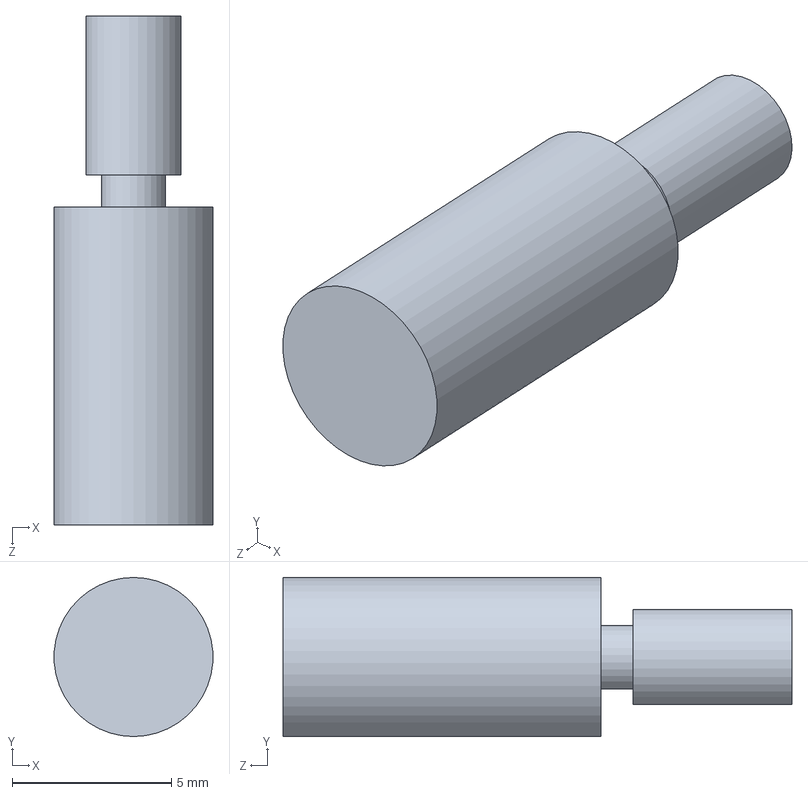
[picture p28: CAD file, 2026-09-27]
02_mechanical/00_SW2023-Hermes/12-Patikil-Standoff-M3x10-6mm.SLDPRT
4.99 x 5.00 x 16.0 mm
