ahkar-kyaw/e_me599_Hermes/02_mechanical/00_SW2023-Hermes/22-Mount-Actuator-3.SLDPRT

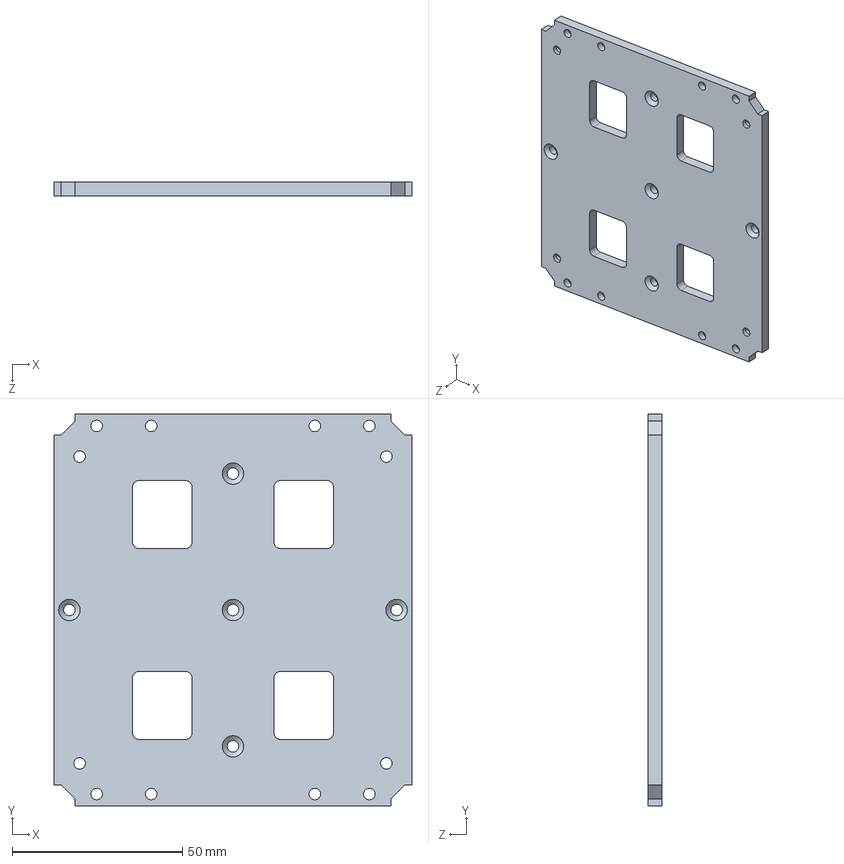
[picture p29: CAD file, 2026-09-27]
02_mechanical/00_SW2023-Hermes/22-Mount-Actuator-3.SLDPRT
105.0 x 115.0 x 4.00 mm
