ahkar-kyaw/e_me599_Hermes/02_mechanical/00_SW2023-Hermes/12_XT60.SLDPRT

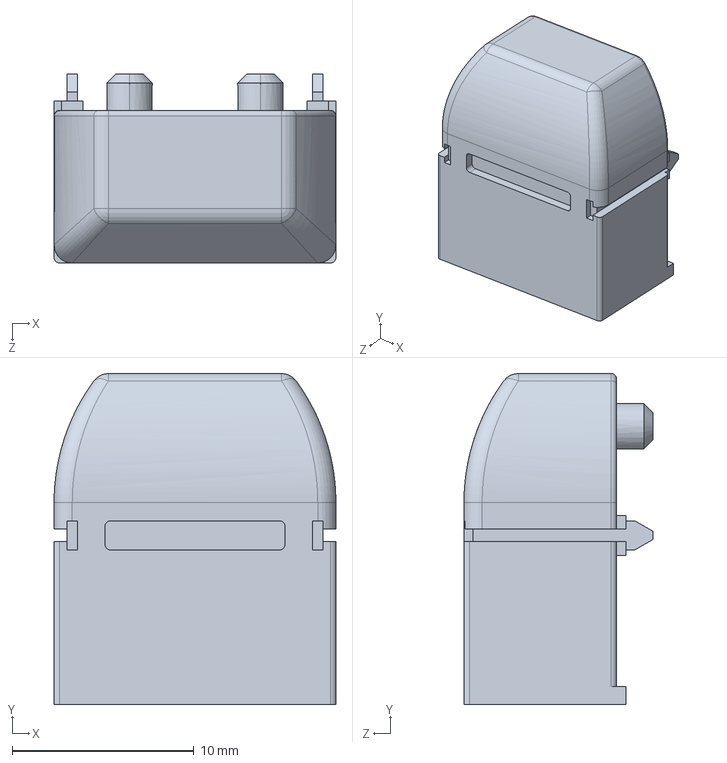
[picture p30: CAD file, 2026-09-27]
02_mechanical/00_SW2023-Hermes/12_XT60.SLDPRT
15.5 x 18.2 x 10.4 mm
