ahkar-kyaw/e_me599_Hermes/02_mechanical/00_SW2023-Hermes/XT60E-M.STEP

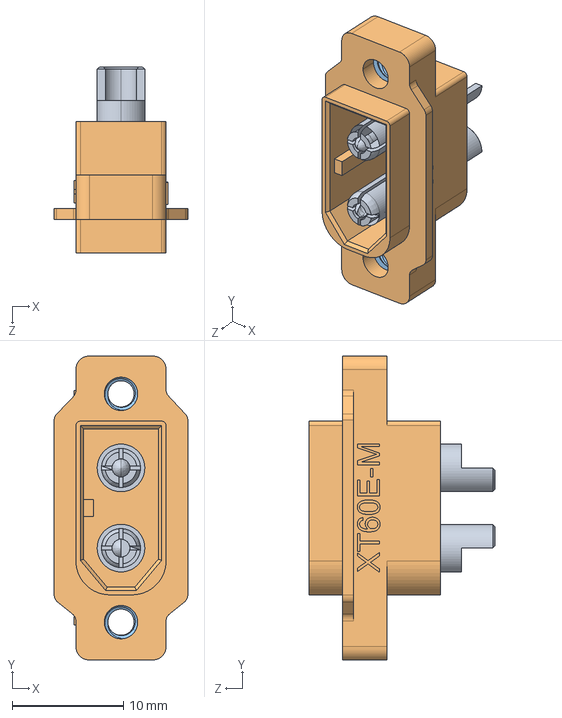
[picture p31: CAD file, 2026-09-27]
02_mechanical/00_SW2023-Hermes/XT60E-M.STEP
12.0 x 27.3 x 16.7 mm
