ahkar-kyaw/e_me599_Hermes/02_mechanical/00_SW2023-Hermes/12-Radiomaster-RP2.SLDPRT

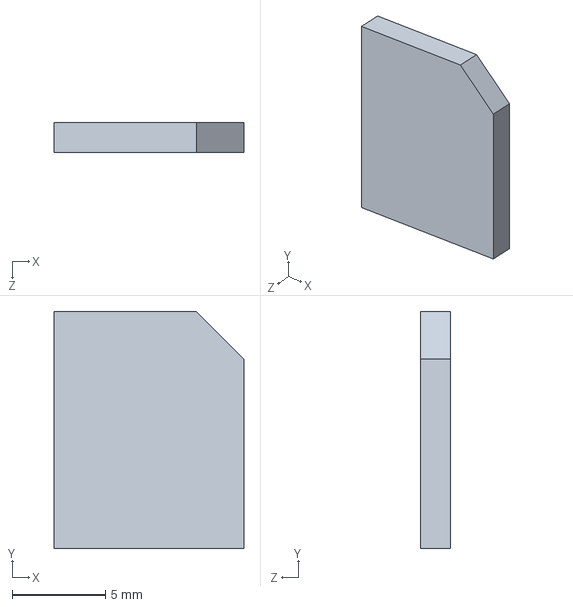
[picture p32: CAD file, 2026-09-27]
02_mechanical/00_SW2023-Hermes/12-Radiomaster-RP2.SLDPRT
10.2 x 12.7 x 1.60 mm
