ahkar-kyaw/e_me599_Hermes/02_mechanical/00_SW2023-Hermes/12-PhoenixContact-1715721.SLDPRT

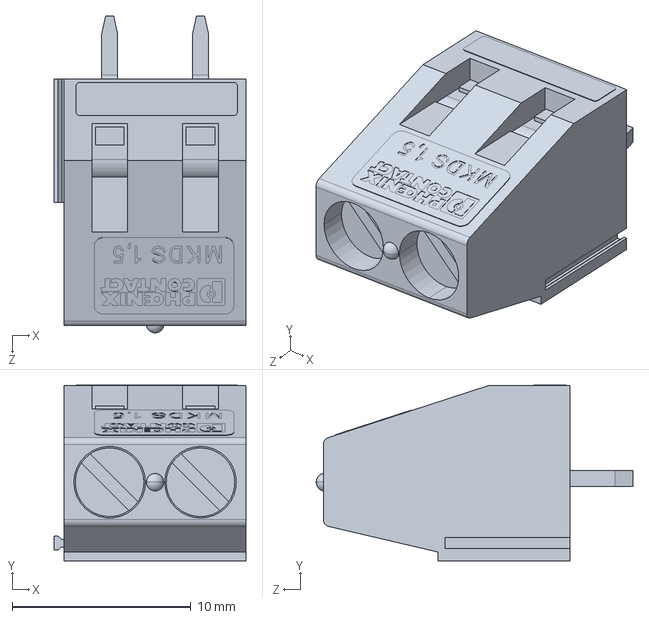
[picture p33: CAD file, 2026-09-27]
02_mechanical/00_SW2023-Hermes/12-PhoenixContact-1715721.SLDPRT
10.7 x 9.83 x 17.7 mm
