ahkar-kyaw/e_me599_Hermes/02_mechanical/00_SW2023-Hermes/1309-0016-4008.STEP

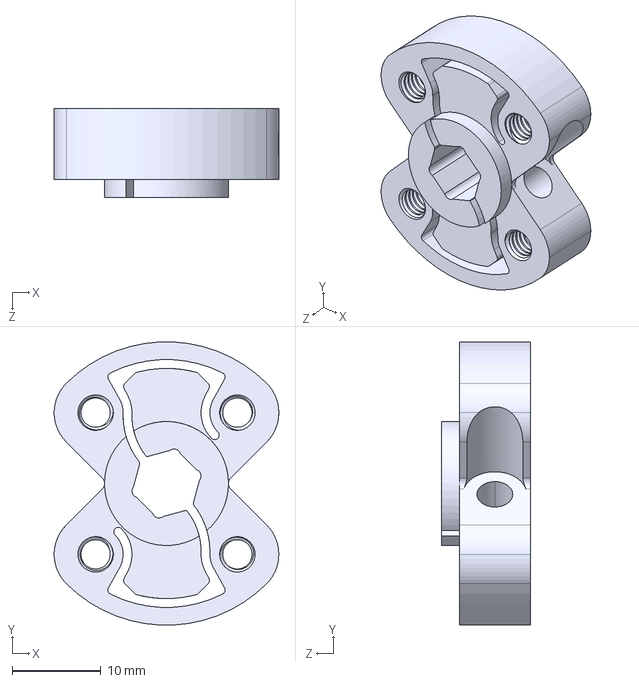
[picture p34: CAD file, 2026-09-27]
02_mechanical/00_SW2023-Hermes/1309-0016-4008.STEP
25.4 x 32.0 x 10.0 mm
