ahkar-kyaw/e_me599_Hermes/02_mechanical/00_SW2023-Hermes/Pin Header 1x3 TH Pitch 2.54mm.STEP

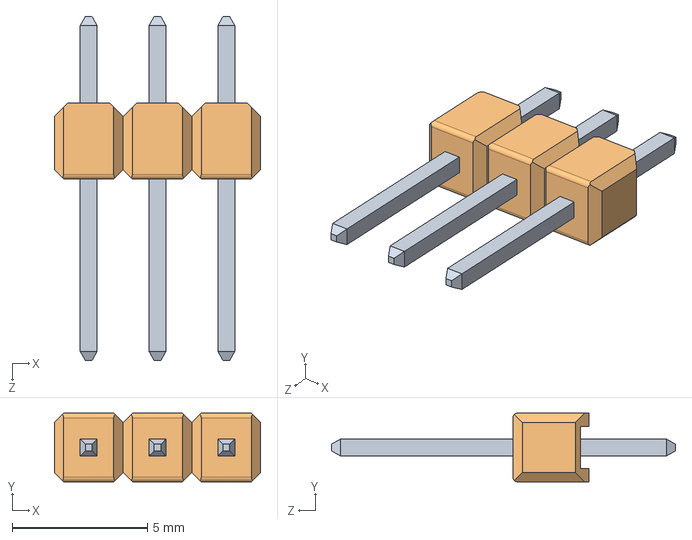
[picture p36: CAD file, 2026-09-27]
02_mechanical/00_SW2023-Hermes/Pin Header 1x3 TH Pitch 2.54mm.STEP
7.62 x 2.54 x 12.7 mm
