ahkar-kyaw/e_me599_Hermes/02_mechanical/00_SW2023-Hermes/12-goBILDA-1105-0005-0128.SLDPRT

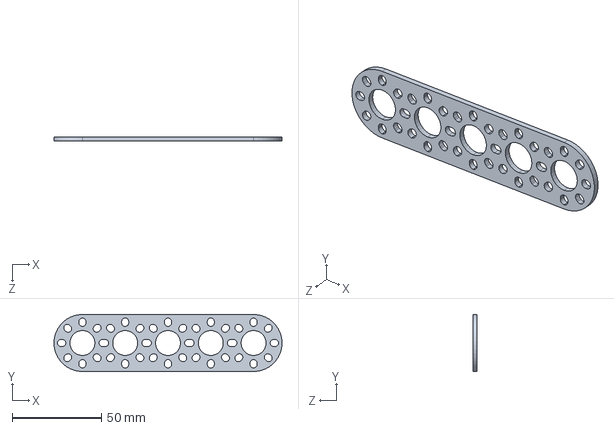
[picture p37: CAD file, 2026-09-27]
02_mechanical/00_SW2023-Hermes/12-goBILDA-1105-0005-0128.SLDPRT
127.9 x 32.0 x 2.50 mm
