ahkar-kyaw/e_me599_Hermes/02_mechanical/00_SW2023-Hermes/21-PCBA.SLDASM

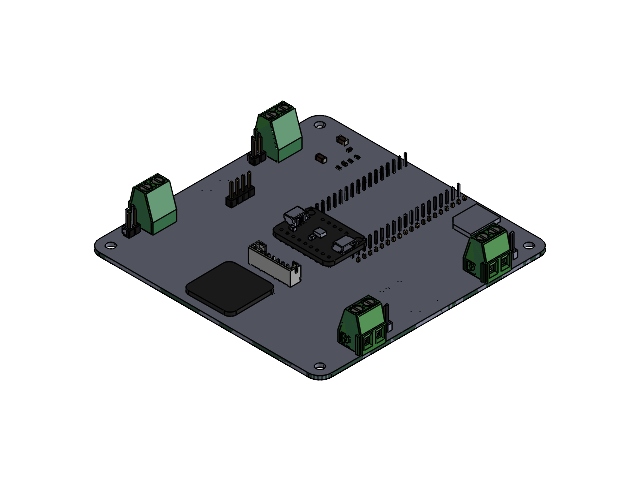
[picture p38: CAD file, 2026-09-27]
02_mechanical/00_SW2023-Hermes/21-PCBA.SLDASM
22-PCB
12-Adafruit-CanPal
12-Adafruit-ISM330DHXC
12-Radiomaster-RP2
12-NodeMCU-ESP32-Wroom32s
12-JST-B8B-PH-K-S
12-LT8609S
12-PhoenixContact-1715721 x 4
12_HeaderPin x 4
C_1206_3216Metric-0.step x 2
TerminalBlock_Phoenix_MKDS-1,5-2-5.08_1x02_P5.08mm_Horizontal-1.step x 4
JST_B8B_PH_K.step
PinHeader_1x02_P254mm_Vertical.step x 4
R_0603_1608Metric-2.step x 3
PinHeader_1x04_P254mm_Vertical.step
C_0603_1608Metric-3.step x 2
PinHeader_1x19_P254mm_Vertical.step x 2
NodeMCU-ESP32-Wroom32s.step
esp32_nodemcu_PCB.step
