ahkar-kyaw/e_me599_Hermes/(list of files, cad)

Other CAD files:
02_mechanical/00_SW2023-Hermes/01_Template_Assembly_Z-Up.SLDASM
02_mechanical/00_SW2023-Hermes/3421-0014-0060/3421-0014-0060.STEP
02_mechanical/00_SW2023-Hermes/3625-0202-0104/3625-0100-0104.step
02_mechanical/00_SW2023-Hermes/02_Template_Part_Z-Up.SLDPRT
02_mechanical/00_SW2023-Hermes/12-JST-B8B-PH-K-S.SLDPRT
02_mechanical/00_SW2023-Hermes/1516-4008-0160.STEP
02_mechanical/00_SW2023-Hermes/Pin Header 1x2 TH Pitch 2.54mm.STEP
02_mechanical/00_SW2023-Hermes/22-Mount-Actuator-7.SLDPRT
02_mechanical/00_SW2023-Hermes/12-CubeMars-AK40-10-V2-KV170.SLDPRT
02_mechanical/00_SW2023-Hermes/2106 Series 8mm REX e-clip.STEP
02_mechanical/00_SW2023-Hermes/12-Adafruit-ISM330DHXC.SLDPRT
02_mechanical/00_SW2023-Hermes/ESP32Wroom32s.STEP
02_mechanical/00_SW2023-Hermes/2106-4008-1920.STEP
02_mechanical/00_SW2023-Hermes/XT60PW MALE.STEP
02_mechanical/00_SW2023-Hermes/12-LT8609S.SLDPRT
02_mechanical/00_SW2023-Hermes/12-XT60E-M.SLDPRT
02_mechanical/00_SW2023-Hermes/22-Mount-Actuator-4.SLDPRT
02_mechanical/00_SW2023-Hermes/12-Patikil-Standoff-M3x20-6mm.SLDPRT
02_mechanical/00_SW2023-Hermes/12-goBILDA-1309-0016-4008.SLDPRT
02_mechanical/00_SW2023-Hermes/Waveshare-2inch-LCD-Module.STEP
02_mechanical/00_SW2023-Hermes/12-goBILDA-3421-0014-0060-screw.SLDPRT
02_mechanical/00_SW2023-Hermes/1715721.STEP
02_mechanical/00_SW2023-Hermes/3421-0014-0060/3421-0014-0060 screw.STEP
