ahkar-kyaw/e_me599_Hermes/02_mechanical/00_SW2023-Hermes/Manufacturer/Cubemars AK40-10 V2 KV170/ak40-10-robotic-actuator-2d-drawing.pdf

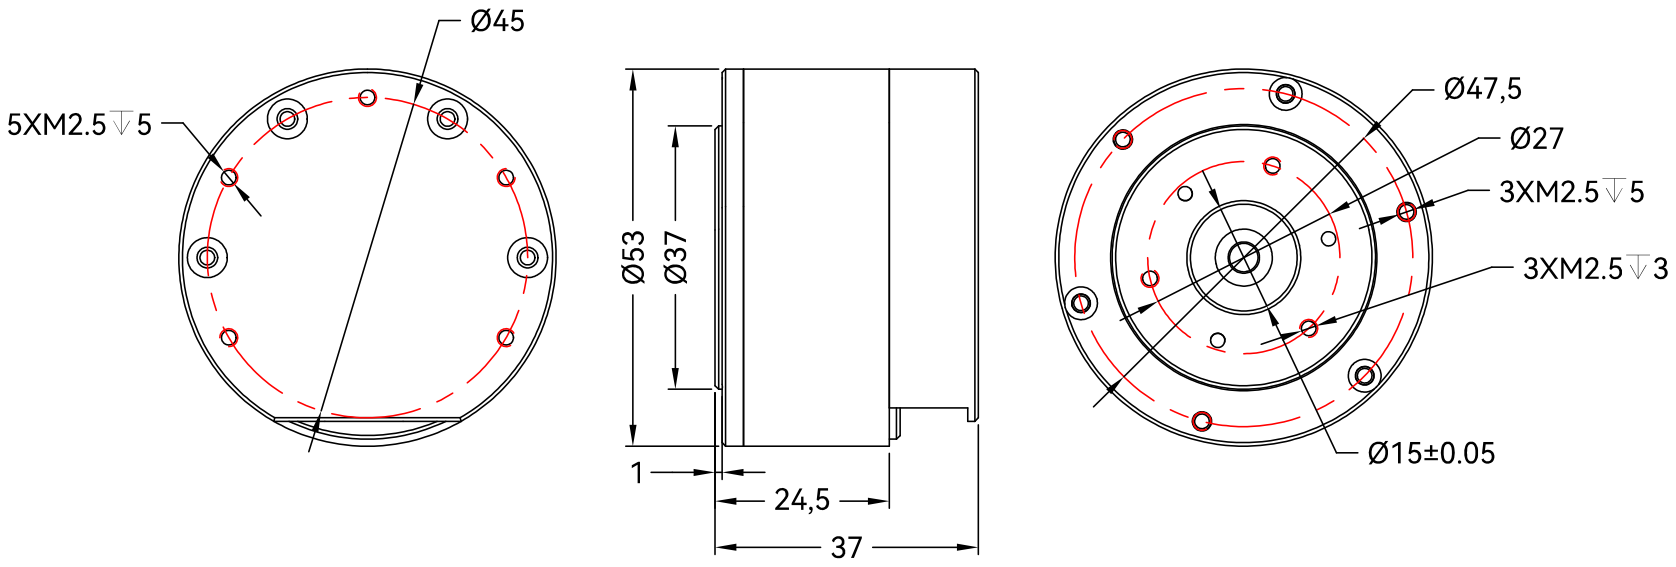
[picture p39: page 1]
