ahkar-kyaw/e_me599_Hermes/03_electrical/esp32_nodemcu/esp32_nodemcu.kicad_pcb

## KiCad design 03_electrical/esp32_nodemcu/esp32_nodemcu.kicad_pcb (2026-09-18)

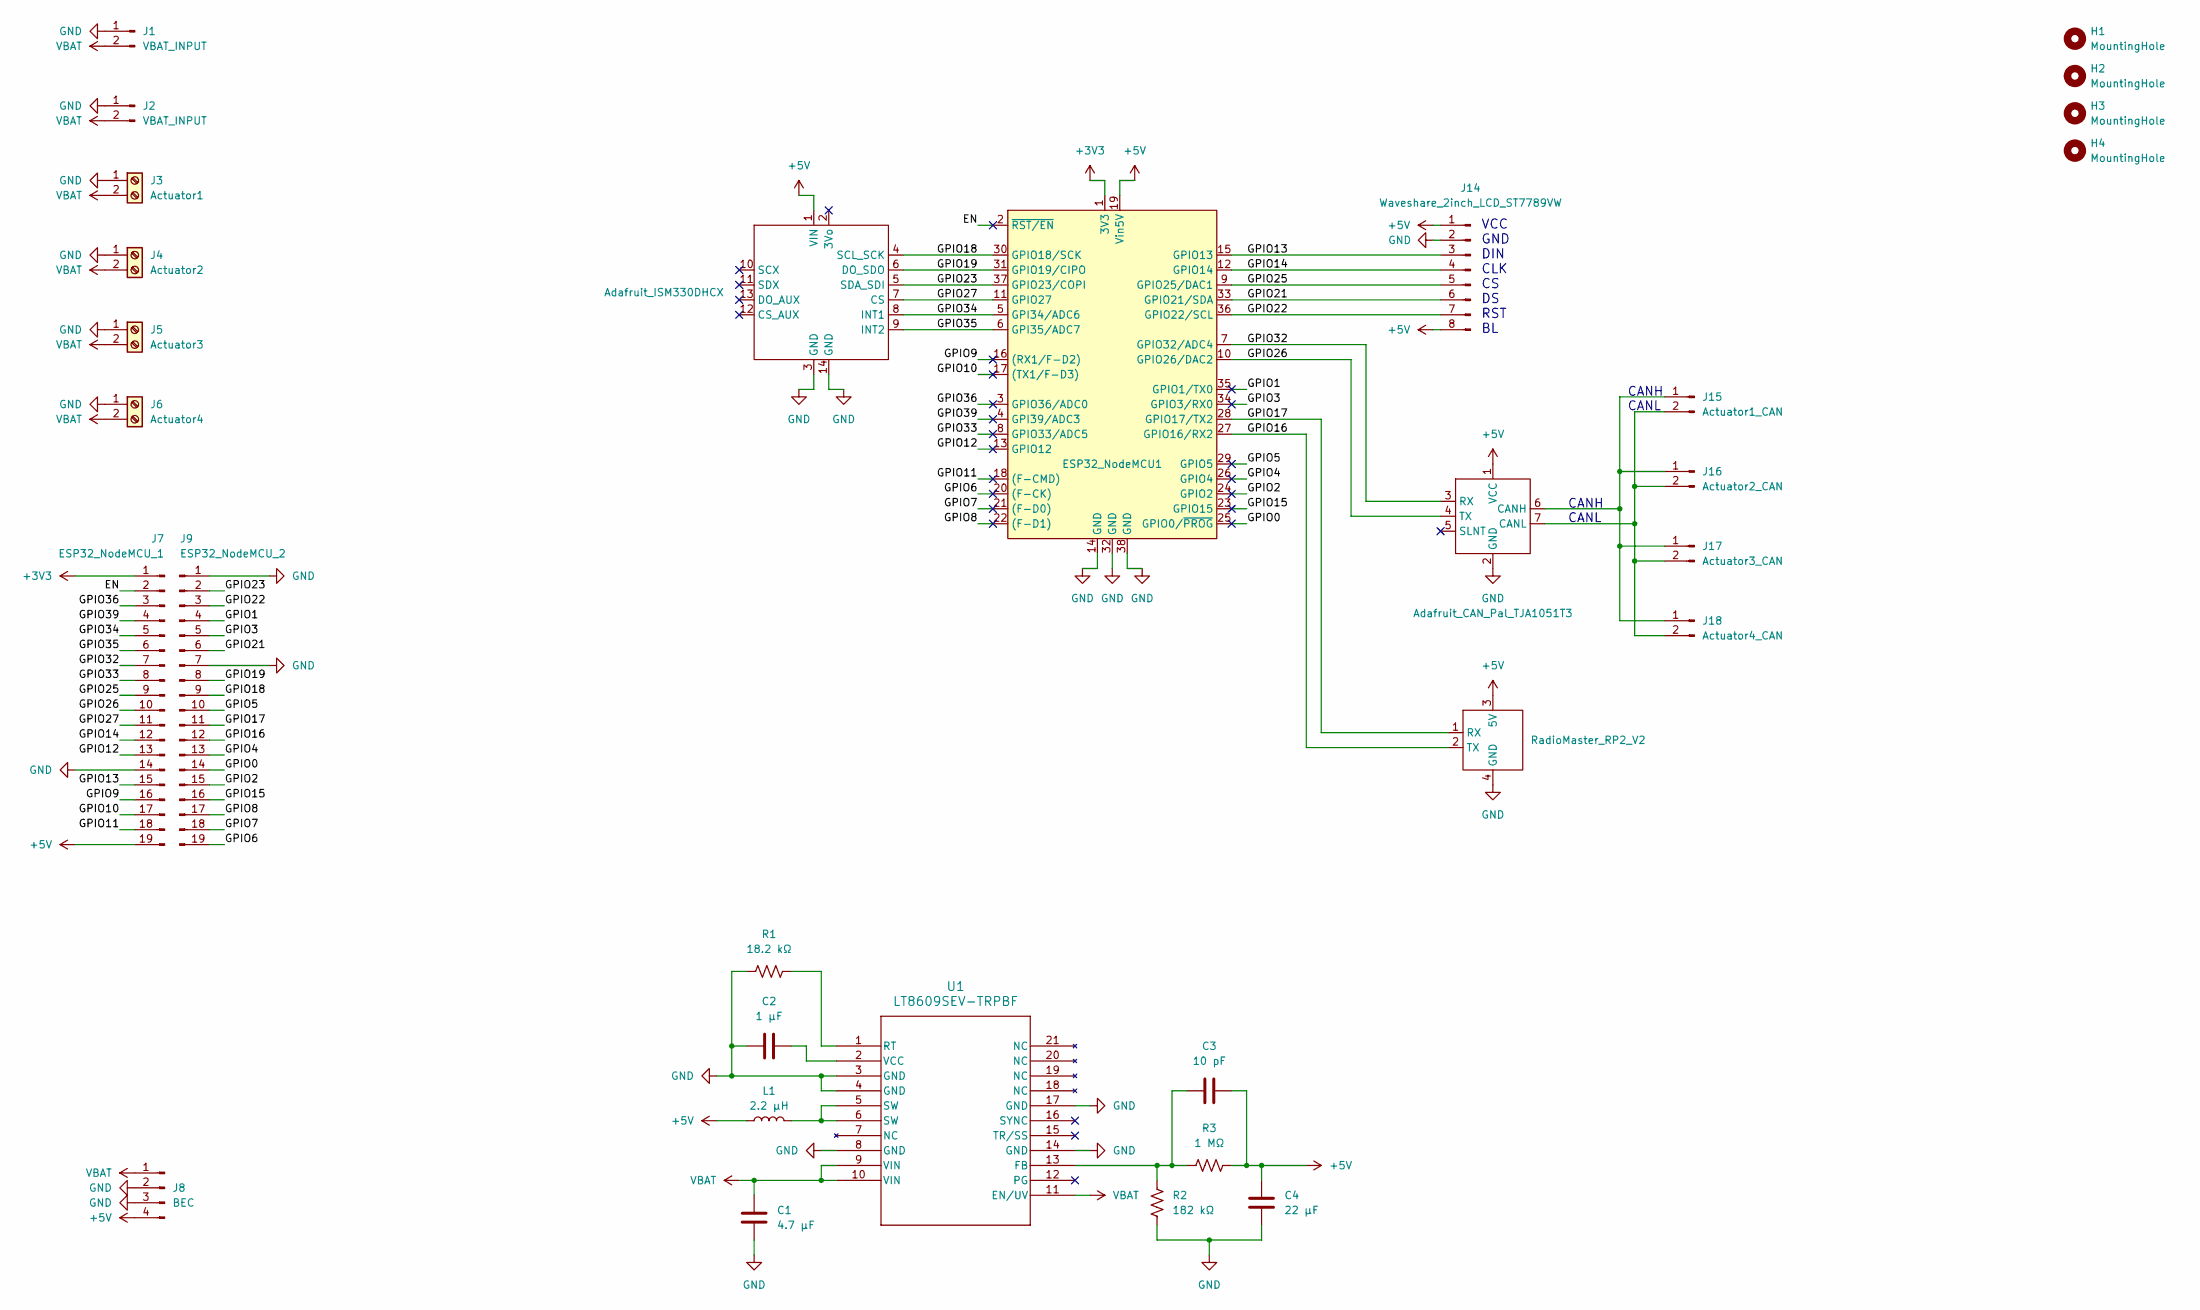
[picture p40: schematic esp32_nodemcu.kicad_sch]

Parts:
A1: Adafruit_ISM330DHCX
A2: Adafruit_CAN_Pal_TJA1051T3
A3: RadioMaster_RP2_V2
C1: 4.7 μF; C_1206_3216Metric_Pad1.33x1.80mm_HandSolder
C2: 1 μF; C_0603_1608Metric_Pad1.08x0.95mm_HandSolder
C3: 10 pF; C_0603_1608Metric_Pad1.08x0.95mm_HandSolder
C4: 22 μF; C_1206_3216Metric_Pad1.33x1.80mm_HandSolder
H1, H2, H3, H4: MountingHole; MountingHole_3.5mm_Pad_TopBottom
J1, J2: VBAT_INPUT; 12GaugePower
J3: Actuator1; TerminalBlock_Phoenix_MKDS-1,5-2-5.08_1x02_P5.08mm_Horizont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
J4: Actuator2; TerminalBlock_Phoenix_MKDS-1,5-2-5.08_1x02_P5.08mm_Horizont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
J5: Actuator3; TerminalBlock_Phoenix_MKDS-1,5-2-5.08_1x02_P5.08mm_Horizont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
J6: Actuator4; TerminalBlock_Phoenix_MKDS-1,5-2-5.08_1x02_P5.08mm_Horizont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
J7: ESP32_NodeMCU_1; PinHeader_1x19_P2.54mm_Vertical
J8: BEC; PinHeader_1x04_P2.54mm_Vertical
J9: ESP32_NodeMCU_2; PinHeader_1x19_P2.54mm_Vertical
J14: Waveshare_2inch_LCD_ST7789VW; JST_PH_B8B-PH-K_1x08_P2.00mm_Vertical
J15: Actuator1_CAN; PinHeader_1x02_P2.54mm_Vertical
J16: Actuator2_CAN; PinHeader_1x02_P2.54mm_Vertical
J17: Actuator3_CAN; PinHeader_1x02_P2.54mm_Vertical
J18: Actuator4_CAN; PinHeader_1x02_P2.54mm_Vertical
L1: 2.2 μH; L_Coilcraft_XxL4020
R1: 18.2 kΩ; R_0603_1608Metric_Pad0.98x0.95mm_HandSolder
R2: 182 kΩ; R_0603_1608Metric_Pad0.98x0.95mm_HandSolder
R3: 1 MΩ; R_0603_1608Metric_Pad0.98x0.95mm_HandSolder
U1: LT8609SEV-TRPBF; 05-08-1516_ADI
U2: ESP32_NodeMCU1; ESP32_NodeMCU

Connections:
+3V3: J7.1, U2.1 (3V3)
+5V: A1.1 (VIN), A2.1 (VCC), A3.3 (5V), C3.2, C4.1, J7.19, J8.4, J14.1, J14.8, L1.1, R3.1, U2.19 (Vin5V)
/EN: J7.2, U2.2 (~RST/EN)
/GPIO0: J9.14, U2.25 (GPIO0/~PROG)
/GPIO1: J9.4, U2.35 (GPIO1/TX0)
/GPIO2: J9.15, U2.24 (GPIO2)
/GPIO3: J9.5, U2.34 (GPIO3/RX0)
/GPIO4: J9.13, U2.26 (GPIO4)
/GPIO5: J9.10, U2.29 (GPIO5)
/GPIO6: J9.19, U2.20 ((F-CK))
/GPIO7: J9.18, U2.21 ((F-D0))
/GPIO8: J9.17, U2.22 ((F-D1))
/GPIO9: J7.16, U2.16 ((RX1/F-D2))
/GPIO10: J7.17, U2.17 ((TX1/F-D3))
/GPIO11: J7.18, U2.18 ((F-CMD))
/GPIO12: J7.13, U2.13 (GPIO12)
/GPIO13: J7.15, J14.3, U2.15 (GPIO13)
/GPIO14: J7.12, J14.4, U2.12 (GPIO14)
/GPIO15: J9.16, U2.23 (GPIO15)
/GPIO16: A3.2 (TX), J9.12, U2.27 (GPIO16/RX2)
/GPIO17: A3.1 (RX), J9.11, U2.28 (GPIO17/TX2)
/GPIO18: A1.4 (SCL_SCK), J9.9, U2.30 (GPIO18/SCK)
/GPIO19: A1.6 (DO_SDO), J9.8, U2.31 (GPIO19/CIPO)
/GPIO21: J9.6, J14.6, U2.33 (GPIO21/SDA)
/GPIO22: J9.3, J14.7, U2.36 (GPIO22/SCL)
/GPIO23: A1.5 (SDA_SDI), J9.2, U2.37 (GPIO23/COPI)
/GPIO25: J7.9, J14.5, U2.9 (GPIO25/DAC1)
/GPIO26: A2.4 (TX), J7.10, U2.10 (GPIO26/DAC2)
/GPIO27: A1.7 (CS), J7.11, U2.11 (GPIO27)
/GPIO32: A2.3 (RX), J7.7, U2.7 (GPIO32/ADC4)
/GPIO33: J7.8, U2.8 (GPIO33/ADC5)
/GPIO34: A1.8 (INT1), J7.5, U2.5 (GPI34/ADC6)
/GPIO35: A1.9 (INT2), J7.6, U2.6 (GPI35/ADC7)
/GPIO36: J7.3, U2.3 (GPIO36/ADC0)
/GPIO39: J7.4, U2.4 (GPI39/ADC3)
GND: A1.3 (GND), A1.14 (GND), A2.2 (GND), A3.4 (GND), C1.2, C2.1, C4.2, J1.1, J2.1, J3.1, J4.1, J5.1, J6.1, J7.14, J8.2, J8.3, J9.1, J9.7, J14.2, R1.1, R2.1, U1.3 (GND), U1.4 (GND), U1.8 (GND), U1.14 (GND), U1.17 (GND), U2.14 (GND), U2.32 (GND), U2.38 (GND)
unnamed: A2.6 (CANH), J15.1, J16.1, J17.1, J18.1
unnamed: A2.7 (CANL), J15.2, J16.2, J17.2, J18.2
unnamed: L1.2, U1.5 (SW), U1.6 (SW)
unnamed: C3.1, R2.2, R3.2, U1.13 (FB)
unnamed: R1.2, U1.1 (RT)
unnamed: C2.2, U1.2 (VCC)
VBAT: C1.1, J1.2, J2.2, J3.2, J4.2, J5.2, J6.2, J8.1, U1.9 (VIN), U1.10 (VIN), U1.11 (EN/UV)

Notes on the sheet:
CANH CANL
VCC GND DIN CLK CS DS RST BL

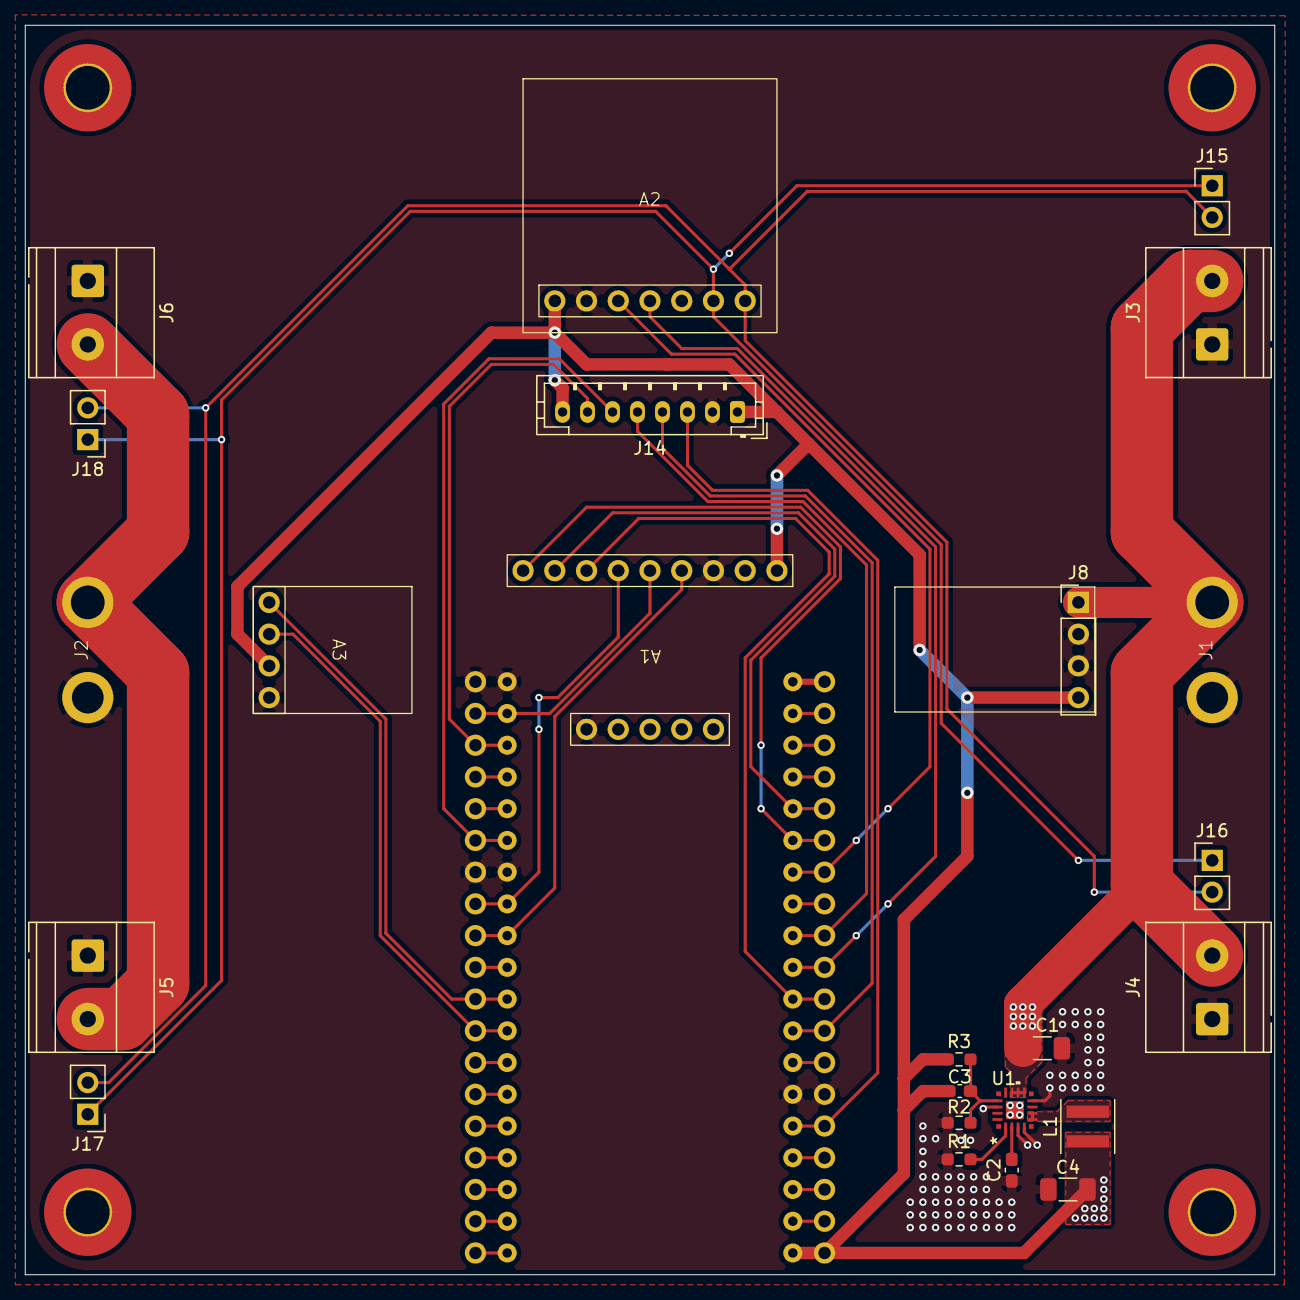
[picture p41: board esp32_nodemcu.kicad_pcb from above]

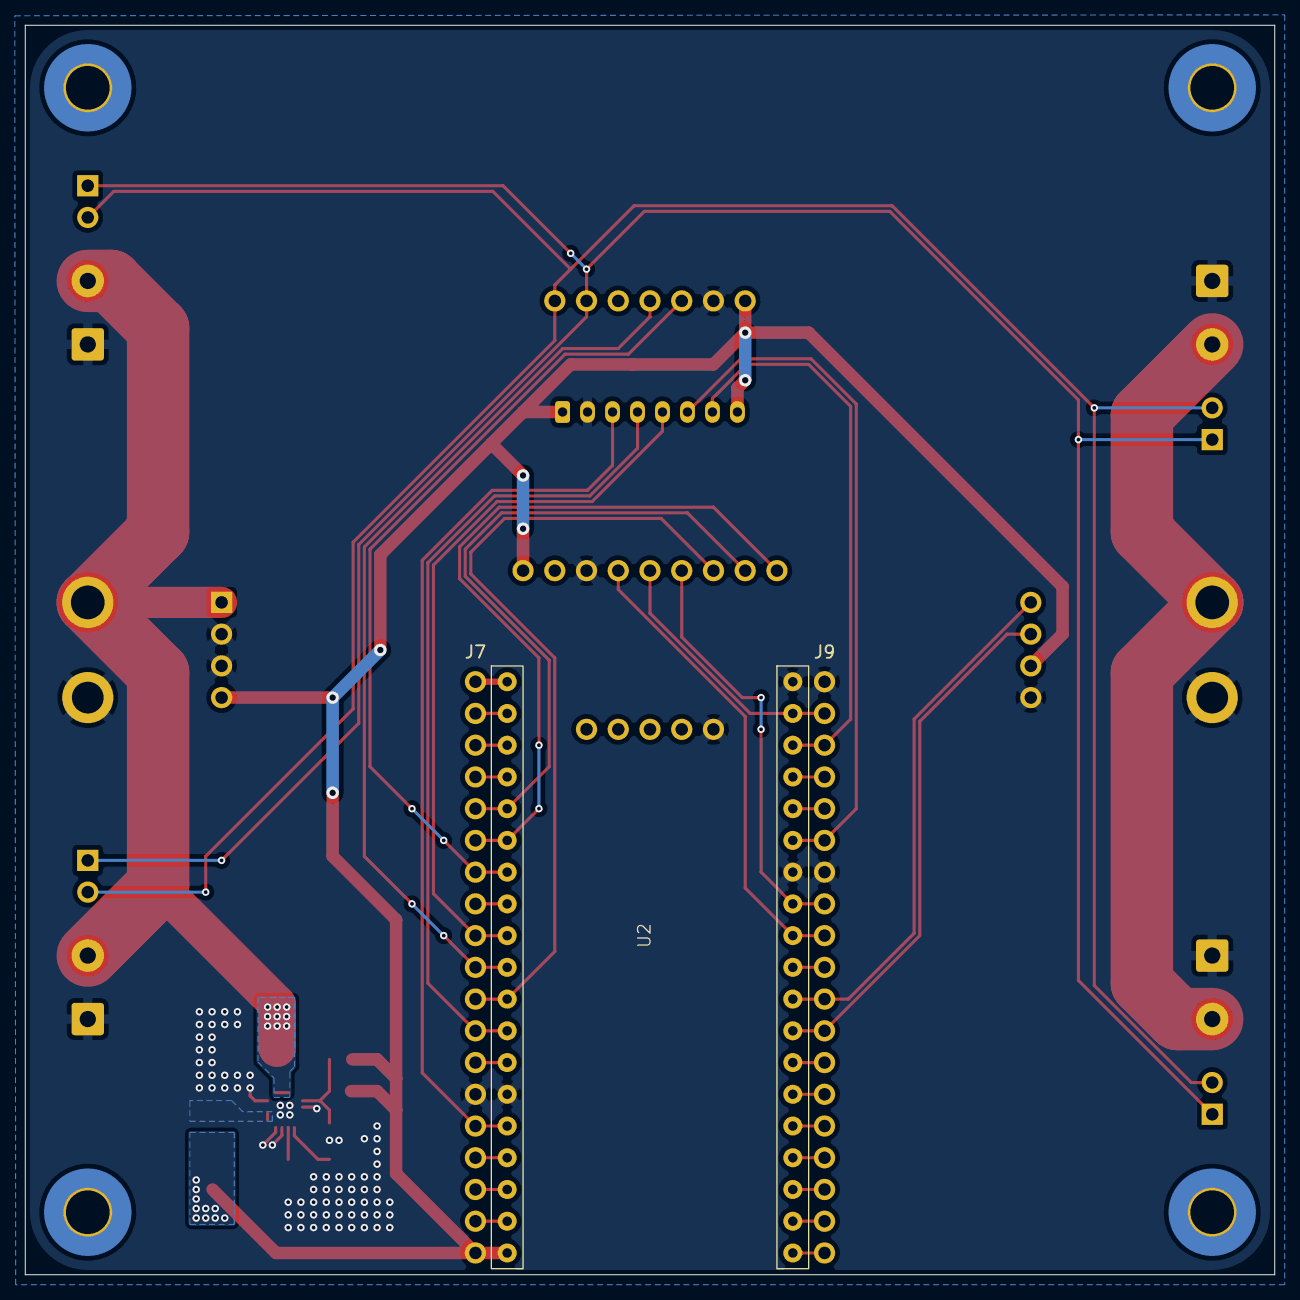
[picture p42: board esp32_nodemcu.kicad_pcb from below]

Board: 2 copper layers, 100.0 x 100.0 mm, 31 parts (3 on the bottom side), 43 nets.
