ahkar-kyaw/e_me599_Hermes/04_firmware/platforms/esp32/main/config/config_control.h

#ifndef CONFIG_CONTROL_H
#define CONFIG_CONTROL_H

#include "control/ctrl_balance_types.h"

#define APP_CONTROL_TASK_PERIOD_MS       5u
#define APP_CONTROL_MAX_DT_S             0.020f

#define APP_CONTROL_WHEEL_RADIUS_M       0.052f
#define APP_CONTROL_MOTOR_POLE_PAIRS     7.0f
#define APP_CONTROL_GEAR_RATIO          10.0f
#define APP_CONTROL_ERPM_TO_WHEEL_RADPS \
    (0.1047197551f / \
     (APP_CONTROL_MOTOR_POLE_PAIRS * APP_CONTROL_GEAR_RATIO))

/* Paper convention: forward y, right x, positive yaw CCW. */
#define APP_CONTROL_WHEEL_1_OFFSET_M        0.095f
#define APP_CONTROL_WHEEL_2_OFFSET_M        0.033f
#define APP_CONTROL_WHEEL_3_OFFSET_M       -0.033f
#define APP_CONTROL_WHEEL_4_OFFSET_M       -0.095f
#define APP_CONTROL_WHEEL_1_ROLLER_ANGLE_RAD  0.7853982f
#define APP_CONTROL_WHEEL_2_ROLLER_ANGLE_RAD -0.7853982f
#define APP_CONTROL_WHEEL_3_ROLLER_ANGLE_RAD  0.7853982f
#define APP_CONTROL_WHEEL_4_ROLLER_ANGLE_RAD -0.7853982f
#define APP_CONTROL_YAW_SCALE_M              0.095f

#define APP_CONTROL_LEAN_AXIS CTRL_BALANCE_LEAN_PITCH

#define APP_MOTION_MAX_FORWARD_VELOCITY_MPS  0.35f
#define APP_MOTION_MAX_LATERAL_VELOCITY_MPS  0.25f
#define APP_MOTION_MAX_YAW_RATE_RPS           0.80f
#define APP_MOTION_MAX_FORWARD_ACCEL_MPS2     0.50f
#define APP_MOTION_MAX_LATERAL_ACCEL_MPS2     0.40f
#define APP_MOTION_MAX_YAW_ACCEL_RPS2         1.00f

#define APP_BALANCE_FORWARD_OUTPUT_SIGN        1.0f
#define APP_BALANCE_LATERAL_OUTPUT_SIGN        1.0f
#define APP_BALANCE_YAW_OUTPUT_SIGN            1.0f
#define APP_BALANCE_INITIAL_LEAN_TRIM_RAD       0.0f
#define APP_BALANCE_ZERO_MAX_ABS_LEAN_RAD       0.2617994f
#define APP_BALANCE_ZERO_MAX_LEAN_RATE_RPS      0.1745329f

#define APP_BALANCE_LEAN_GAIN_A_PER_RAD         6.0f
#define APP_BALANCE_LEAN_RATE_GAIN_A_PER_RPS    0.50f
#define APP_BALANCE_FORWARD_POSITION_GAIN_A_PER_M 0.40f
#define APP_BALANCE_FORWARD_VELOCITY_GAIN_A_PER_MPS 1.20f
#define APP_BALANCE_FORWARD_INTEGRAL_GAIN_A_PER_M_S 0.0f
#define APP_BALANCE_FORWARD_INTEGRAL_LIMIT_M_S  1.0f

#define APP_BALANCE_LATERAL_POSITION_GAIN_A_PER_M 0.40f
#define APP_BALANCE_LATERAL_VELOCITY_GAIN_A_PER_MPS 1.60f
#define APP_BALANCE_LATERAL_INTEGRAL_GAIN_A_PER_M_S 0.0f
#define APP_BALANCE_LATERAL_INTEGRAL_LIMIT_M_S  1.0f

#define APP_BALANCE_YAW_POSITION_GAIN_A_PER_RAD 0.20f
#define APP_BALANCE_YAW_RATE_GAIN_A_PER_RPS     0.70f
#define APP_BALANCE_YAW_INTEGRAL_GAIN_A_PER_RAD_S 0.0f
#define APP_BALANCE_YAW_INTEGRAL_LIMIT_RAD_S    1.0f

#define APP_BALANCE_MAX_FORWARD_POSITION_ERROR_M 0.35f
#define APP_BALANCE_MAX_LATERAL_POSITION_ERROR_M 0.35f
#define APP_BALANCE_MAX_YAW_ERROR_RAD             0.5235988f
#define APP_BALANCE_MAX_FORWARD_CURRENT_A         1.0f
#define APP_BALANCE_MAX_LATERAL_CURRENT_A         0.65f
#define APP_BALANCE_MAX_YAW_CURRENT_A             0.60f
#define APP_BALANCE_MAX_CURRENT_A                 1.0f

#define APP_BALANCE_SUPERVISOR_PERIOD_MS           20u
#define APP_BALANCE_REQUEST_MAX_AGE_US          100000u
#define APP_BALANCE_STATE_MAX_AGE_US             20000u
#define APP_BALANCE_ARM_DWELL_US                300000u
#define APP_BALANCE_STOP_HOLD_US                200000u

#define APP_BALANCE_ARM_LEAN_LIMIT_RAD          0.1745329f
#define APP_BALANCE_ARM_LEAN_RATE_LIMIT_RPS     1.3962634f
#define APP_BALANCE_ARM_INPUT_LIMIT             0.10f
#define APP_BALANCE_FALL_LEAN_LIMIT_RAD         0.5235988f

#endif
