ahkar-kyaw/e_me599_Hermes/04_firmware/platforms/esp32/main/config/config_rc.h

#ifndef CONFIG_RC_H
#define CONFIG_RC_H

#include "protocols/proto_crsf.h"

#define APP_RC_MAX_AGE_US              100000u
#define APP_RC_ACTIVE_CHANNEL_COUNT         10u
#define APP_RC_CHANNEL_MIN             PROTO_CRSF_CHANNEL_VALUE_MIN
#define APP_RC_CHANNEL_MAX             PROTO_CRSF_CHANNEL_VALUE_MAX
#define APP_RC_UART_READ_TIMEOUT_MS    20u
#define APP_RC_RETRY_MS                1000u

#define APP_RC_MASTER_ENABLE_CHANNEL   5u
#define APP_RC_BALANCE_ENABLE_CHANNEL  6u
#define APP_RC_ZERO_LEAN_CHANNEL       7u
#define APP_RC_FORWARD_CHANNEL         3u
#define APP_RC_LATERAL_CHANNEL         1u
#define APP_RC_YAW_CHANNEL             4u

#define APP_RC_INPUT_MIN               PROTO_CRSF_CHANNEL_VALUE_1000
#define APP_RC_INPUT_MID               PROTO_CRSF_CHANNEL_VALUE_MID
#define APP_RC_INPUT_MAX               PROTO_CRSF_CHANNEL_VALUE_2000
#define APP_RC_INPUT_DEADBAND          40u

#define APP_RC_SWITCH_OFF_THRESHOLD   600u
#define APP_RC_SWITCH_ON_THRESHOLD   1384u

#define APP_RC_MASTER_ACTIVE_HIGH      1
#define APP_RC_BALANCE_ACTIVE_HIGH     1
#define APP_RC_ZERO_ACTIVE_HIGH        1
#define APP_RC_FORWARD_INVERTED        0
#define APP_RC_LATERAL_INVERTED        0
#define APP_RC_YAW_INVERTED            0

#define APP_OPERATOR_TASK_PERIOD_MS   20u

#endif
