ahkar-kyaw/e_me599_Hermes/04_firmware/common/include/app/app_balance_state.h

#ifndef APP_BALANCE_STATE_H
#define APP_BALANCE_STATE_H

#include "app/app_imu_types.h"
#include "control/ctrl_balance_types.h"
#include "estimation/est_collinear_mecanum.h"
#include "safety/safety_imu.h"

#ifdef __cplusplus
extern "C" {
#endif

bool app_balance_state_imu_ready(
    const safety_imu_status_t *imu_status);

bool app_balance_state_get_lean(
    const imu_snapshot_t *imu,
    const safety_imu_status_t *imu_status,
    ctrl_balance_lean_axis_t lean_axis,
    float *lean_rad,
    float *lean_rate_rps);

bool app_balance_state_compose(
    const imu_snapshot_t *imu,
    const safety_imu_status_t *imu_status,
    const est_collinear_mecanum_output_t *odometry,
    ctrl_balance_lean_axis_t lean_axis,
    uint64_t timestamp_us,
    balance_state_t *balance_state);

#ifdef __cplusplus
}
#endif

#endif
