ahkar-kyaw/e_me599_Hermes/04_firmware/platforms/esp32/main/tasks/task_motor.h

#ifndef TASK_MOTOR_H
#define TASK_MOTOR_H

#include "app/app_actuator_types.h"
#include "app/app_actuator_command_types.h"

#ifdef __cplusplus
extern "C" {
#endif

void task_motor_start(void);
void task_motor_get_snapshot(actuator_snapshot_t *snapshot);
void task_motor_set_approved_command(
    const app_actuator_command_snapshot_t *command);

#ifdef __cplusplus
}
#endif

#endif
