ahkar-kyaw/e_me599_Hermes/(commit log)

2026-09-08 KiCad save
    [battery_protection.kicad_pcb, battery_protection.kicad_sch, esp32_nodemcu.kicad_pcb, esp32_nodemcu.kicad_sch, power.kicad_sch]
2026-09-13 Electrical Update
    [esp32_nodemcu.kicad_pcb, esp32_nodemcu.kicad_sch]
2026-09-18 electrical r1 checkpoint
    [esp32_nodemcu-B_Cu.gbr, esp32_nodemcu-B_Mask.gbr, esp32_nodemcu-B_Paste.gbr, esp32_nodemcu-B_Silkscreen.gbr, esp32_nodemcu-Edge_Cuts.gbr, esp32_nodemcu-F_Cu.gbr, esp32_nodemcu-F_Mask.gbr, esp32_nodemcu-F_Paste.gbr]
2026-11-09 Actuator ID updated. Actuator can spin independently.
2026-11-10 Tested, motor 2 not working.
    Other than that, all motors spin in sync
2026-11-11 Actuator react to tilt now. Actuator 2 still not working.
2026-11-11 WIP, Actuator 2 code implementation is off.
2026-11-11 All motors drives now. M1 drives a little slow. Will try characterization test.
2026-11-12 Supposed to be production level, but M2 and M3 jitter while M1 and M4 doesn't react much.
